jaegertros/Ukulele/CONCERT 14 UKULELE PLANS/genone_luthier_supply.com/cdn.shopify.com/s/files/1/0081/4261/8677/files/Inside_Form_Packages_421b7cd7-5853-4665-a564-590fb22dc92a_600x.jpg

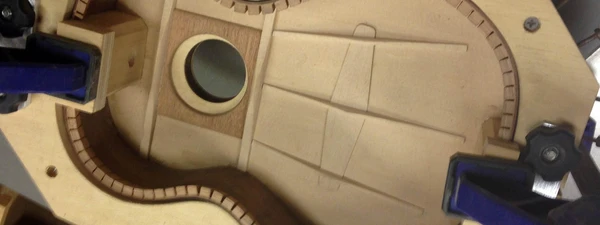
CONCERT 14 UKULELE PLANS/genone_luthier_supply.com/cdn.shopify.com/s/files/1/0081/4261/8677/files/Inside_Form_Packages_421b7cd7-5853-4665-a564-590fb22dc92a_600x.jpg
