jaegertros/Ukulele/CONCERT 14 BELL UKULELE PLANS/genone_luthier_supply.com/cdn.shopify.com/s/files/1/0081/4261/8677/files/IMG_0210_180x180.JPG

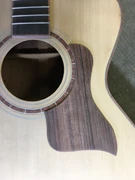
CONCERT 14 BELL UKULELE PLANS/genone_luthier_supply.com/cdn.shopify.com/s/files/1/0081/4261/8677/files/IMG_0210_180x180.JPG
