jaegertros/Ukulele/cad_drawing-b.png

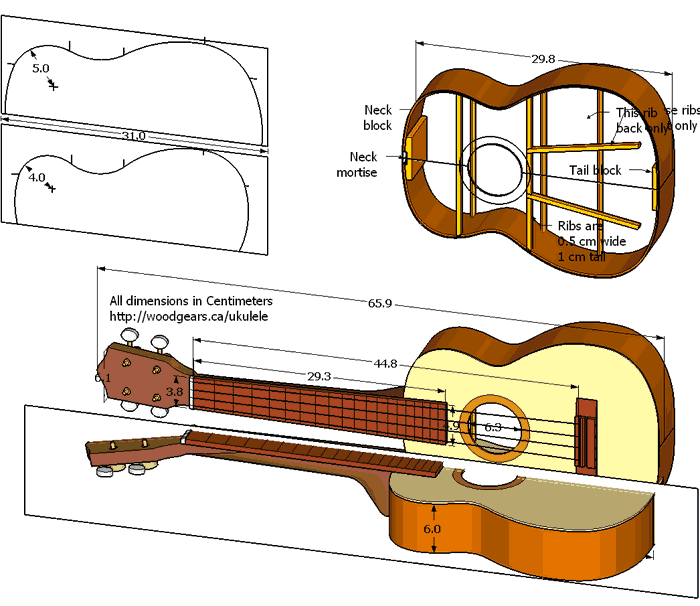
cad_drawing-b.png
