jaegertros/Ukulele/CONCERT 12 UKULELE PLANS/genone_luthier_supply.com/cdn.shopify.com/s/files/1/0081/4261/8677/files/ukulele_600x.jpg

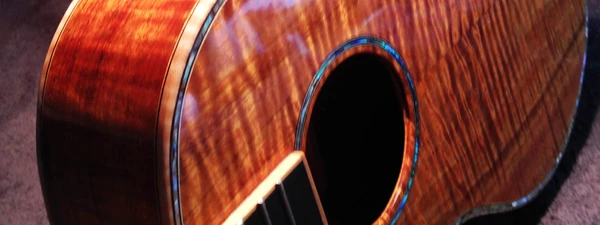
CONCERT 12 UKULELE PLANS/genone_luthier_supply.com/cdn.shopify.com/s/files/1/0081/4261/8677/files/ukulele_600x.jpg
