jaegertros/Ukulele/CONCERT 12 UKULELE PLANS/genone_luthier_supply.com/cdn.shopify.com/s/files/1/0081/4261/8677/products/01_uke14concertplankasha_300x.png

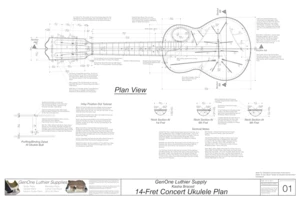
CONCERT 12 UKULELE PLANS/genone_luthier_supply.com/cdn.shopify.com/s/files/1/0081/4261/8677/products/01_uke14concertplankasha_300x.png
