jaegertros/Ukulele/CONCERT 14 BELL UKULELE PLANS/genone_luthier_supply.com/cdn.shopify.com/s/files/1/0081/4261/8677/products/04_ukeconcertdread_4_300x.png

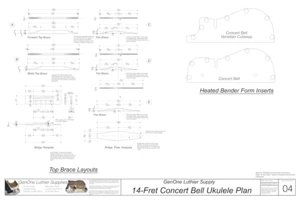
CONCERT 14 BELL UKULELE PLANS/genone_luthier_supply.com/cdn.shopify.com/s/files/1/0081/4261/8677/products/04_ukeconcertdread_4_300x.png
