jaegertros/Ukulele/CONCERT 14 UKULELE PLANS - KASHA BRACED/genone_luthier_supply.com/cdn.shopify.com/s/files/1/0081/4261/8677/products/05_uke14concertplankasha_5_300x.png

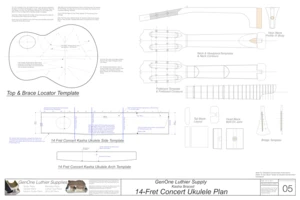
CONCERT 14 UKULELE PLANS - KASHA BRACED/genone_luthier_supply.com/cdn.shopify.com/s/files/1/0081/4261/8677/products/05_uke14concertplankasha_5_300x.png
