jaegertros/Ukulele/CONCERT 14 UKULELE PLANS - KASHA BRACED/genone_luthier_supply.com/cdn.shopify.com/s/files/1/0081/4261/8677/products/06_uke14concertplankashaforms_300x.png

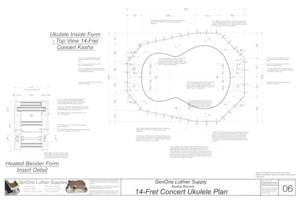
CONCERT 14 UKULELE PLANS - KASHA BRACED/genone_luthier_supply.com/cdn.shopify.com/s/files/1/0081/4261/8677/products/06_uke14concertplankashaforms_300x.png
