jaegertros/Ukulele/CONCERT 14 UKULELE PLANS/02_uke14concertplan_2_300x.jpg

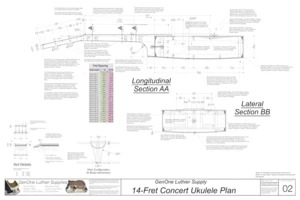
CONCERT 14 UKULELE PLANS/02_uke14concertplan_2_300x.jpg
