jaegertros/Ukulele/CONCERT 14 UKULELE PLANS/genone_luthier_supply.com/cdn.shopify.com/s/files/1/0081/4261/8677/files/CNC_e6f32dc4-443f-4071-a92b-a472cef2e03c_600x.png

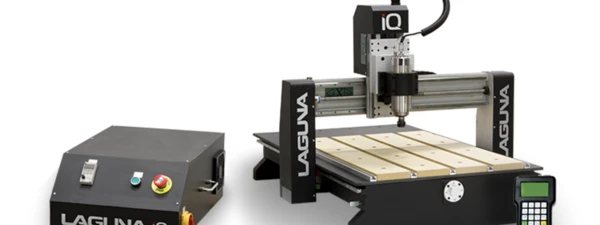
CONCERT 14 UKULELE PLANS/genone_luthier_supply.com/cdn.shopify.com/s/files/1/0081/4261/8677/files/CNC_e6f32dc4-443f-4071-a92b-a472cef2e03c_600x.png
