jaegertros/Ukulele/ukulele_overbend.png

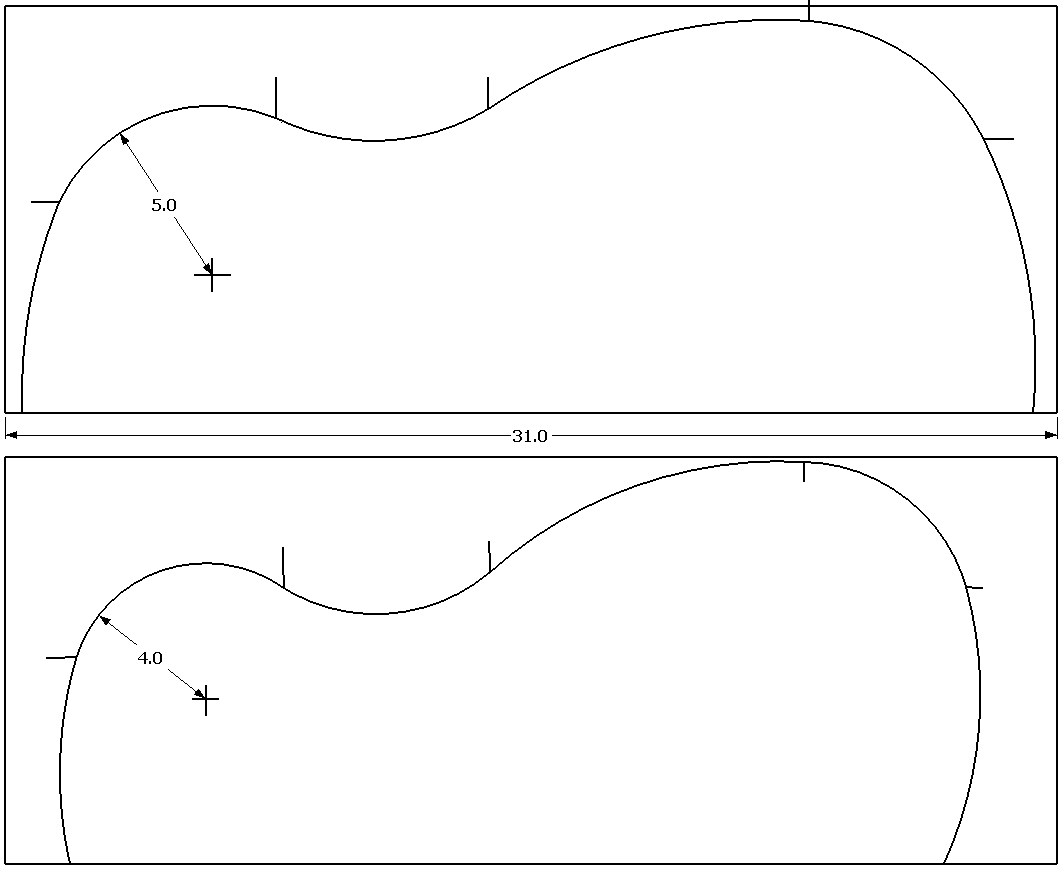
ukulele_overbend.png
