jaegertros/Ukulele/ukulele_profile.png

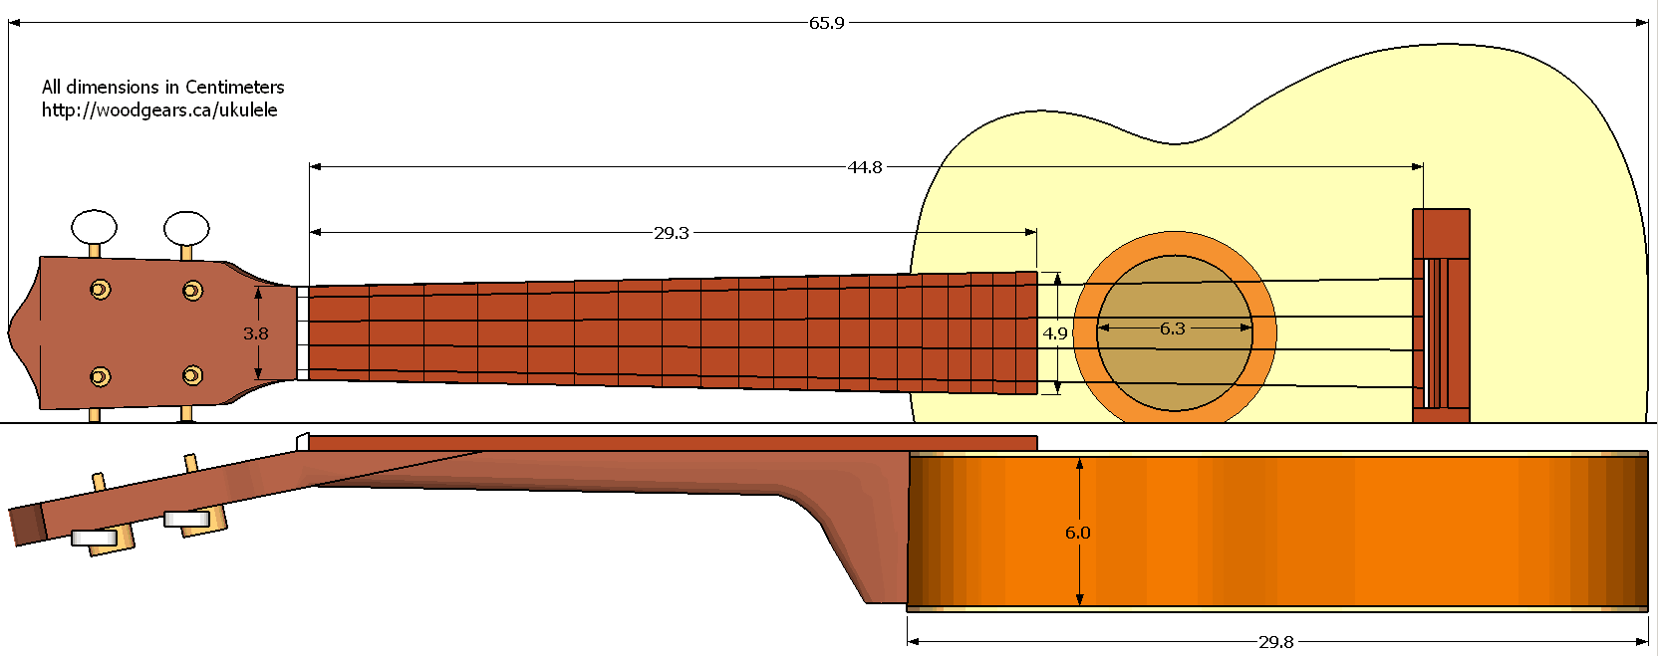
ukulele_profile.png
