jaegertros/Ukulele/ukulele_ribs.png

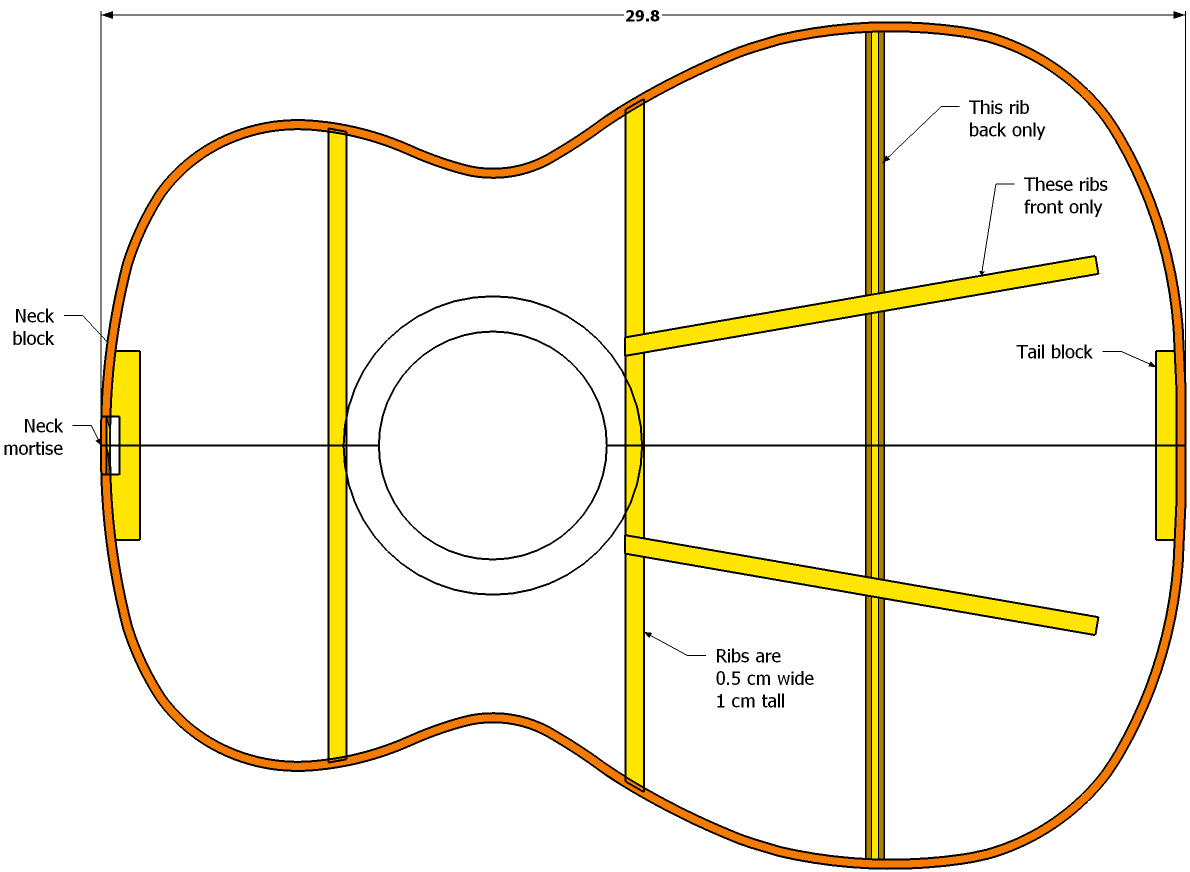
ukulele_ribs.png
