jaegertros/Ukulele/(list of files, cad)

Other CAD files:
ukulele.skp
