jaegertros/Ukulele/woodgears.ca-Making the ukulele fretboard.pdf

## Making the ukulele fretboard

woodgears.ca/ukulele/fretboard.html

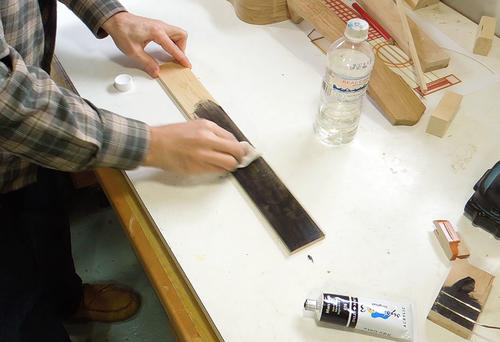
[picture p207: figure]

I used hard maple for the fretboard.

Traditionally, these are made from dark exotic woods, so I figured a dark fretboard would look much better. So I used some black acrylic artist paint to stain the board black.

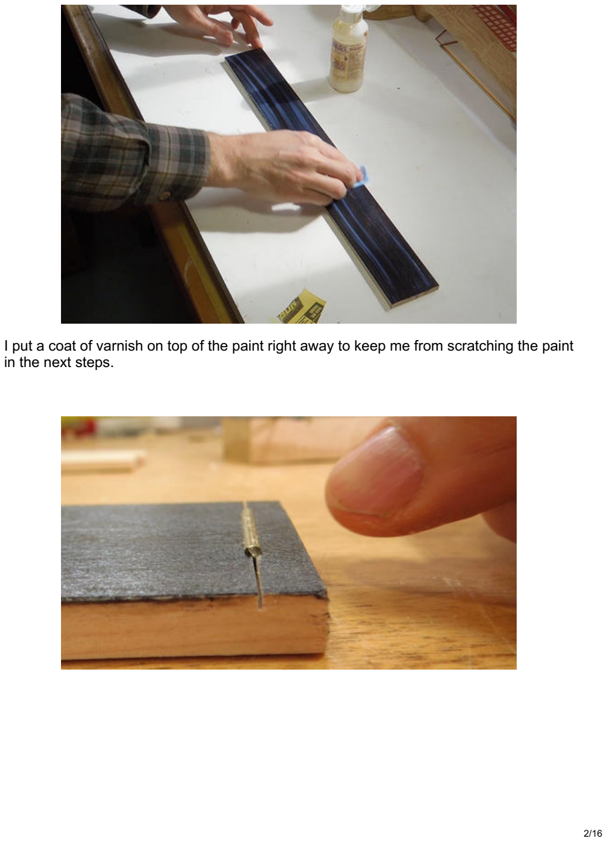
[picture p208: page 2]

I put a coat of varnish on top of the paint right away to keep me from scratching the paint in the next steps.

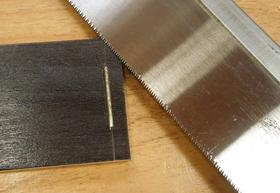
[picture p209: figure]

I tried my Japanese dozuki saw to see if it was suitable for cutting fret slots. I was able to press some scraps of fret into the slot, so I figured the kerf from that saw was wide enough.

### Spacing out the frets

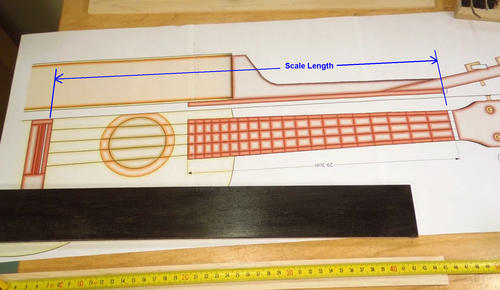
[picture p210: figure]

There are various tools on the web to help you calculate the layout for the frets for guitars or ukuleles. But it's so easy to work these out with a pocket calculator that it's hardly worth the time to learn how to use one of these tools.
I start by determining the "scale length" of my ukulele. The scale length is the length of free string between the bridge and the "nut" at the head of the ukulele.

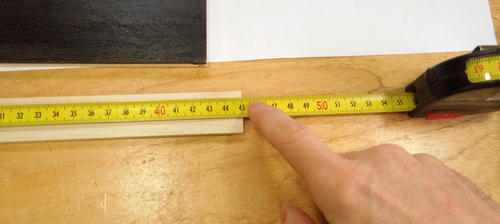
[picture p211: figure]

For my instrument, the scale length came to 45 cm. The math for working out the frets is easy as long as you measure everything from the bridge, not the nut. So I placed my tape measure so that it starts at the bridge position. With my scale length of 45 cm, I put the end of the fretboard (where the "nut" will go) at 45 cm.

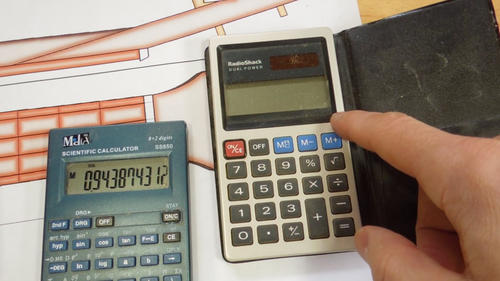
[picture p212: figure]

Starting with the nut, the free string length for each successively higher toned fret is the twelfth root of one half as much. That is, if the nut is at 45 cm, we multiply 45 cm by 0.5 raised to 1/12. So 0.5 raised to one twelfth is 0.94387

I use a calculator with the "constant calculation" feature. Most five function calculators have this feature, but most scientific calculators do not, although this one does. "constant calculation" means that the calculator will repeat the previous operation when
you push "=" again.

So start by multiplying the 0.94387 times itself. Then enter "1" and push "=". If the
display now goes to 0.94387, you are good to go. | 4/16

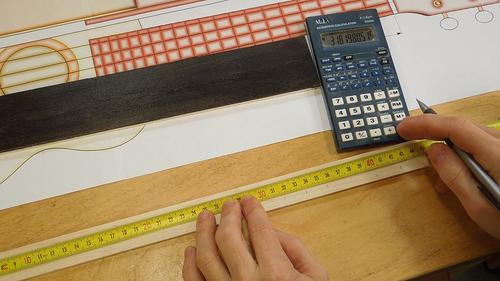
[picture p213: figure]

Now enter the scale length on your calculator and push "=". This should give you the position of the first fret, as measured from the bridge. Mark this position, then push "=" again, and you have the next fret position. Each time you push "=", you get the next fret position.

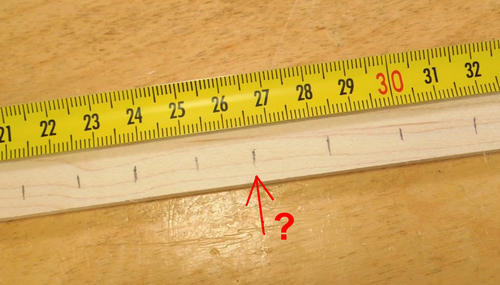
[picture p214: figure]

I marked all the fret positions on a strip of wood. On close inspection, one of the tickmarks looked slightly out of place, so I re-entered the scale length in the calculator and kept pushing "=" again until I got to this position. I had erred by 1.5 mm when I marked this position.

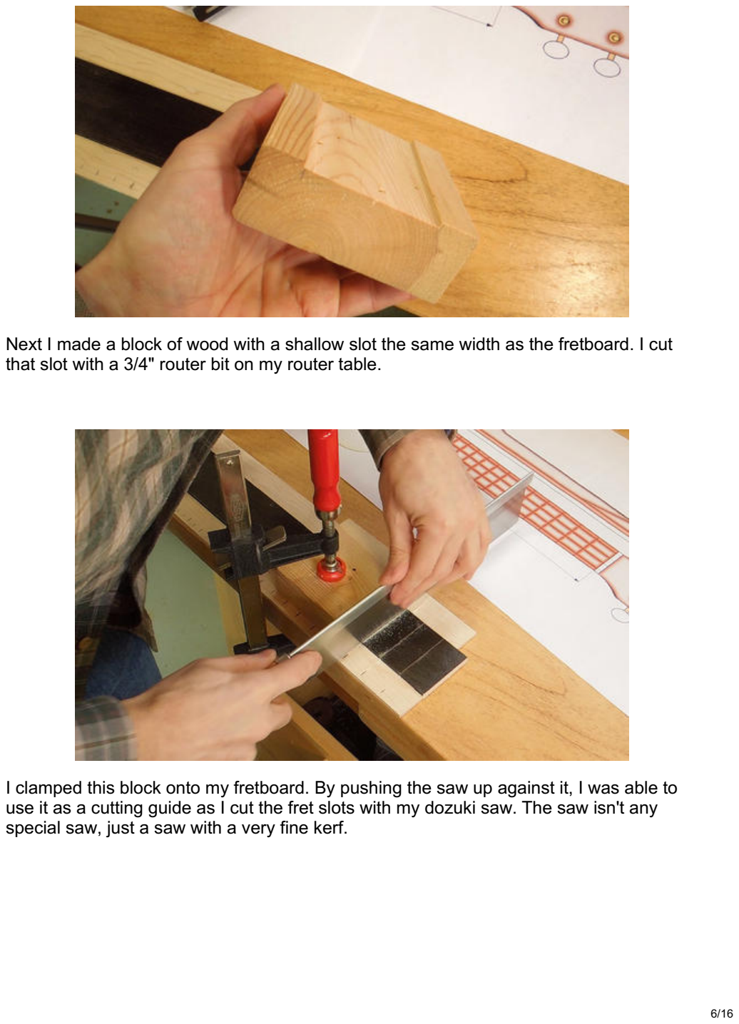
[picture p215: page 6]

Next I made a block of wood with a shallow slot the same width as the fretboard. I cut that slot with a 3/4" router bit on my router table.

I clamped this block onto my fretboard. By pushing the saw up against it, I was able to use it as a cutting guide as I cut the fret slots with my dozuki saw. The saw isn't any special saw, just a saw with a very fine kerf.

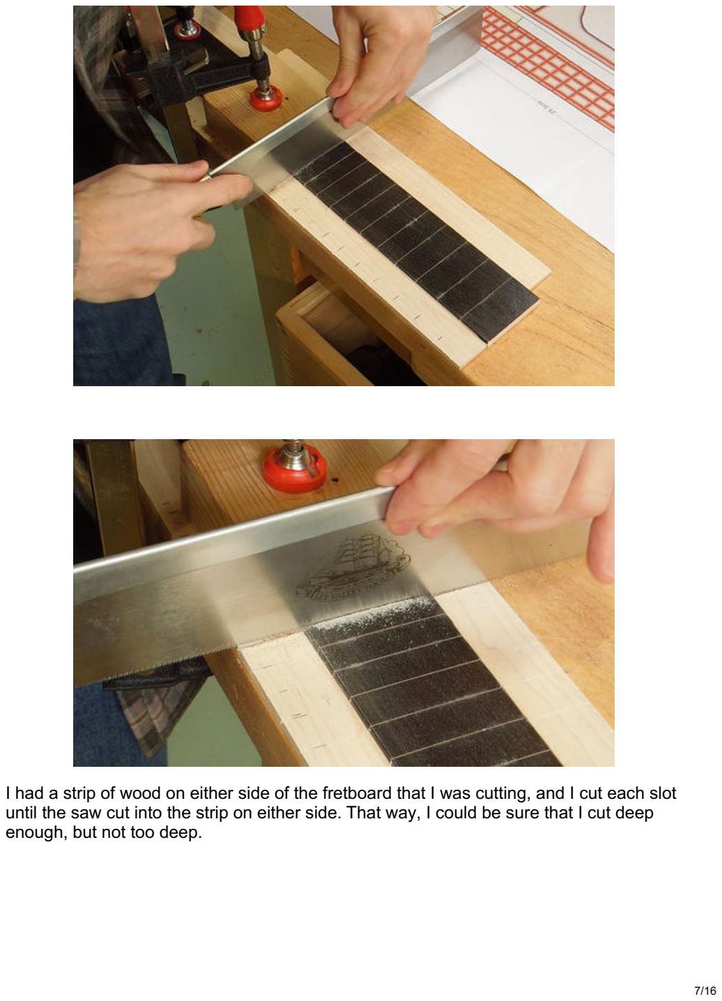
[picture p216: page 7]

I had a strip of wood on either side of the fretboard that I was cutting, and I cut each slot until the saw cut into the strip on either side. That way, I could be sure that I cut deep enough, but not too deep.

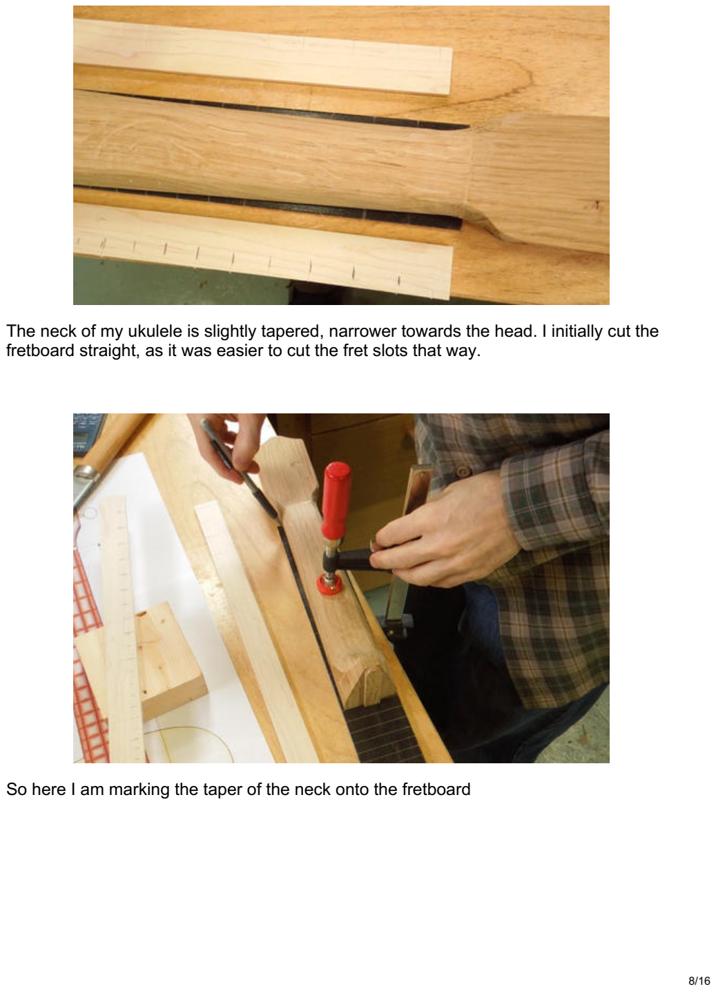
[picture p217: page 8]

The neck of my ukulele is slightly tapered, narrower towards the head. I initially cut the fretboard straight, as it was easier to cut the fret slots that way.

So here I am marking the taper of the neck onto the fretboard

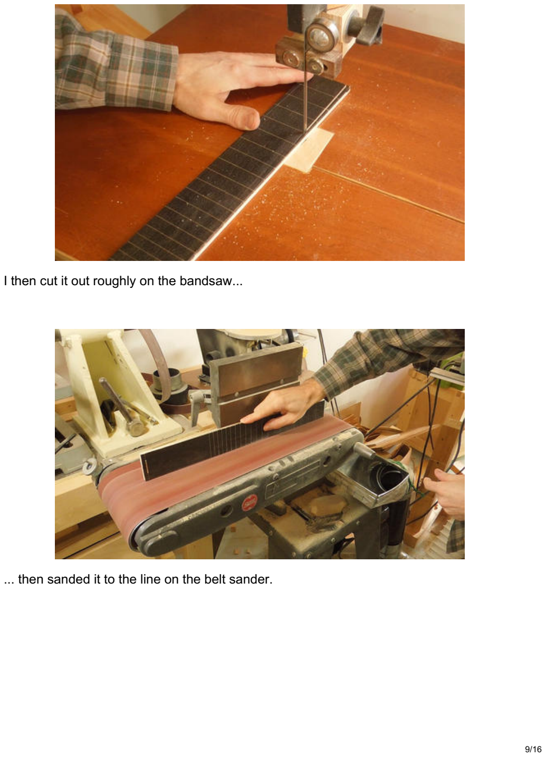
[picture p218: page 9]

I then cut it out roughly on the bandsaw...

... then sanded it to the line on the belt sander.

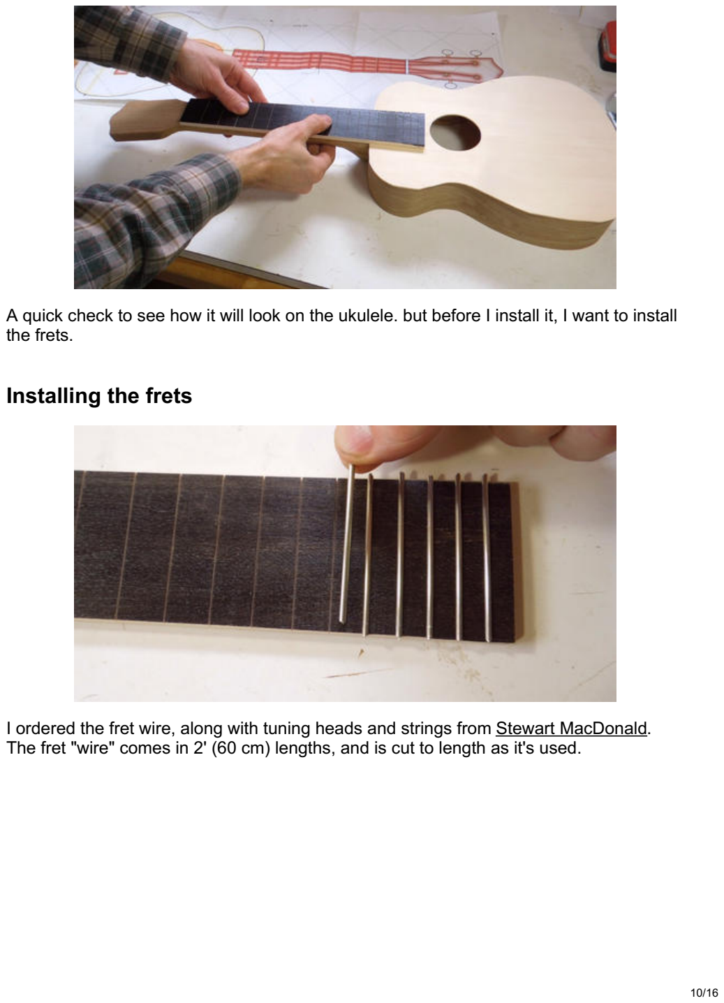
[picture p219: page 10]

A quick check to see how it will look on the ukulele. but before I install it, I want to install the frets.

### Installing the frets

I ordered the fret wire, along with tuning heads and strings from Stewart MacDonald. (http://www.stewmac.com/) The fret "wire" comes in 2' (60 cm) lengths, and is cut to length as it's used.

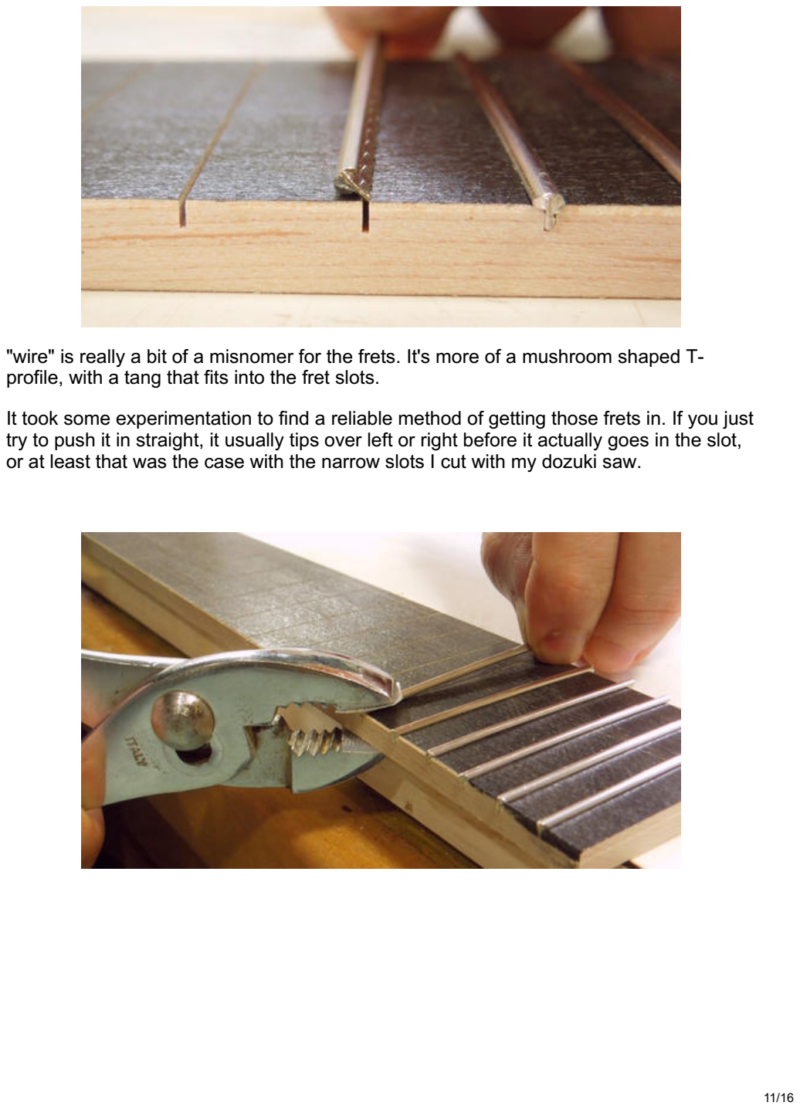
[picture p220: page 11]

"wire" is really a bit of a misnomer for the frets. It's more of a mushroom shaped Tprofile, with a tang that fits into the fret slots.

It took some experimentation to find a reliable method of getting those frets in. If you just try to push it in straight, it usually tips over left or right before it actually goes in the slot, or at least that was the case with the narrow slots I cut with my dozuki saw.

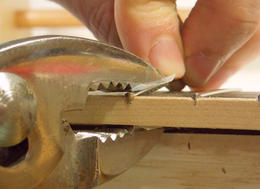
[picture p221: figure]

The method I ended up using was to hold one end of the fret, and squish the other end of it into the slot with pliers. By only squeezing it in at the end, I still had good control of it with my fingers.

I put some pieces of UHMW tape on the jaws of my pliers to keep them from marking up the frets or the wood.

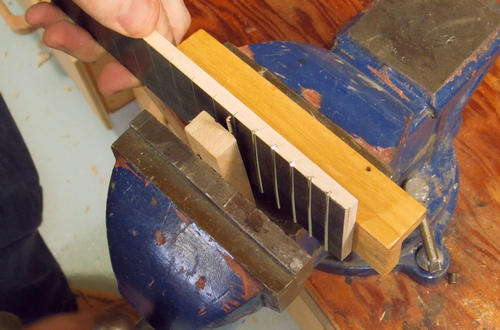
[picture p222: figure]

Once one end of the fret is secure in the slot, it's relatively easy to work across the fretboard to press the rest of it in.

I could have worked it part-way across with the pliers, but that would have caused some sharp bends in the frets. So instead, I used a block of wood in my vise.

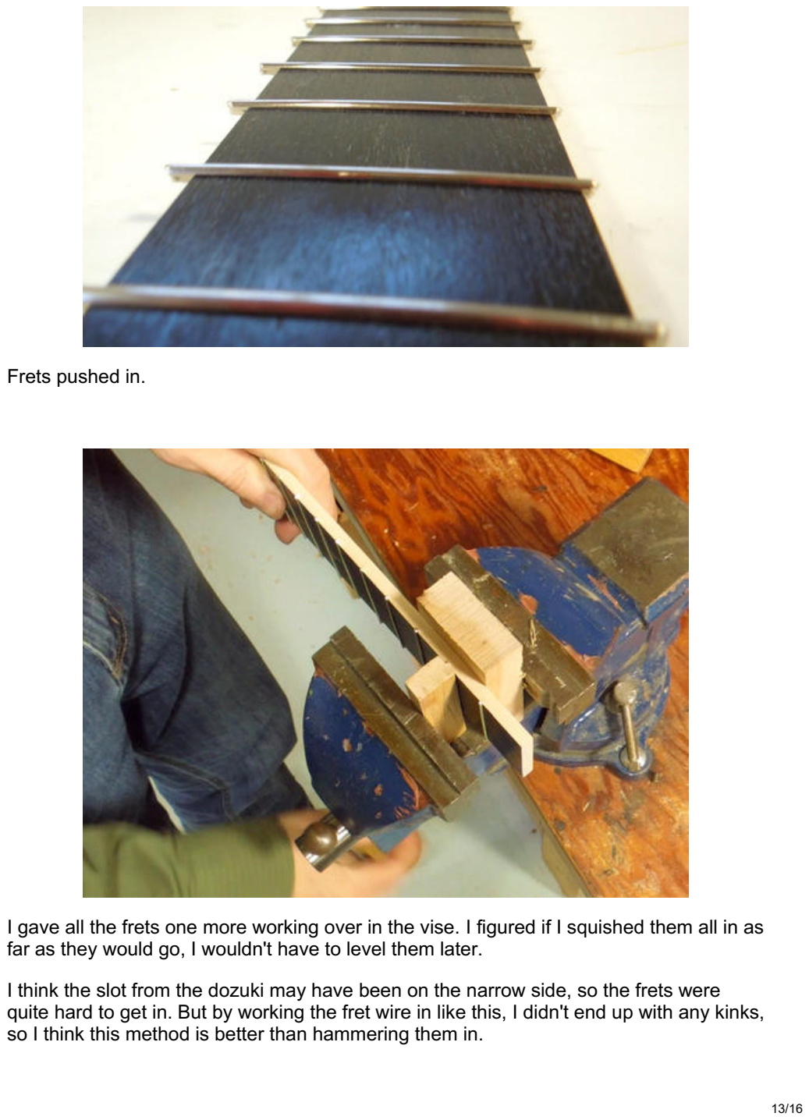
[picture p223: page 13]

Frets pushed in.

I gave all the frets one more working over in the vise. I figured if I squished them all in as far as they would go, I wouldn't have to level them later.

I think the slot from the dozuki may have been on the narrow side, so the frets were
quite hard to get in. But by working the fret wire in like this, I didn't end up with any kinks,
so I think this method is better than hammering them in. | 13/16

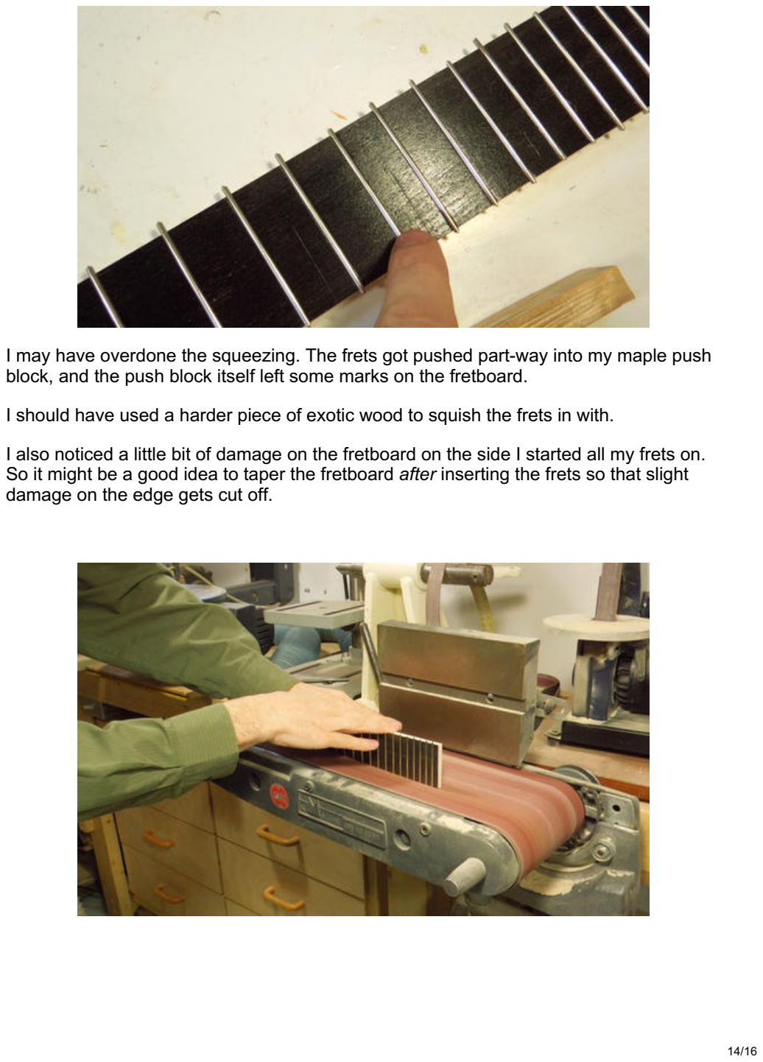
[picture p224: page 14]

I may have overdone the squeezing. The frets got pushed part-way into my maple push block, and the push block itself left some marks on the fretboard.

I should have used a harder piece of exotic wood to squish the frets in with.

I also noticed a little bit of damage on the fretboard on the side I started all my frets on. So it might be a good idea to taper the fretboard after inserting the frets so that slight damage on the edge gets cut off.

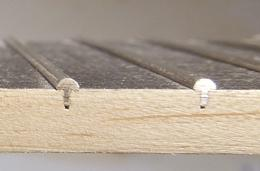
[picture p225: figure]

Next I trimmed the frets flush with the edge on my belt sander. After I got them flush, I tipped the fretboard towards the fret to bevel the ends of the frets in by about 30 degrees.

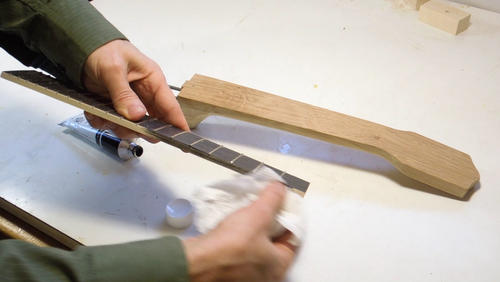
[picture p226: figure]
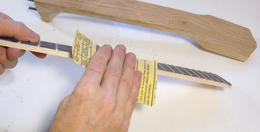
[picture p227: figure]

I also hand-sanded the edges to help round the ends of the frets and the edge of the fretboard between the frets. The edge of the fretboard needs to feel comfortable to reach around.

I then stained the edges of the fretboard to make it look like it was all one black piece of material.

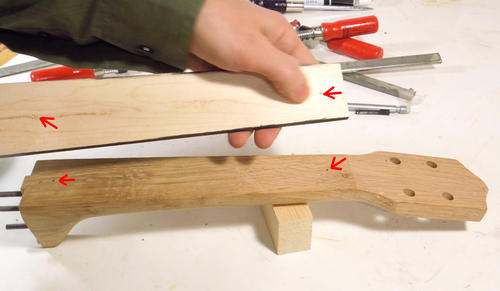
[picture p228: figure]

Glue is a lubricant, and when gluing two flat surfaces together, it often causes the pieces to slide out of alignment. So I drove two finishing nails into the neck and cut them off to stick out about 1.5 mm from the surface.

I then lined up the fretboard and pressed it onto the nails. This resulted in two small divots in the back of the fretboard to keep it aligned during gluing.

See also: Pat making the fretboard (https://woodgears.ca/ukulele/pat_fretboard.html)

Next: Finishing the assembly (https://woodgears.ca/ukulele/finish_up.html)

Drag and Drop

The image will be downloaded

×
