jaegertros/Ukulele/Build a Guitar or Ukulele Body.pdf

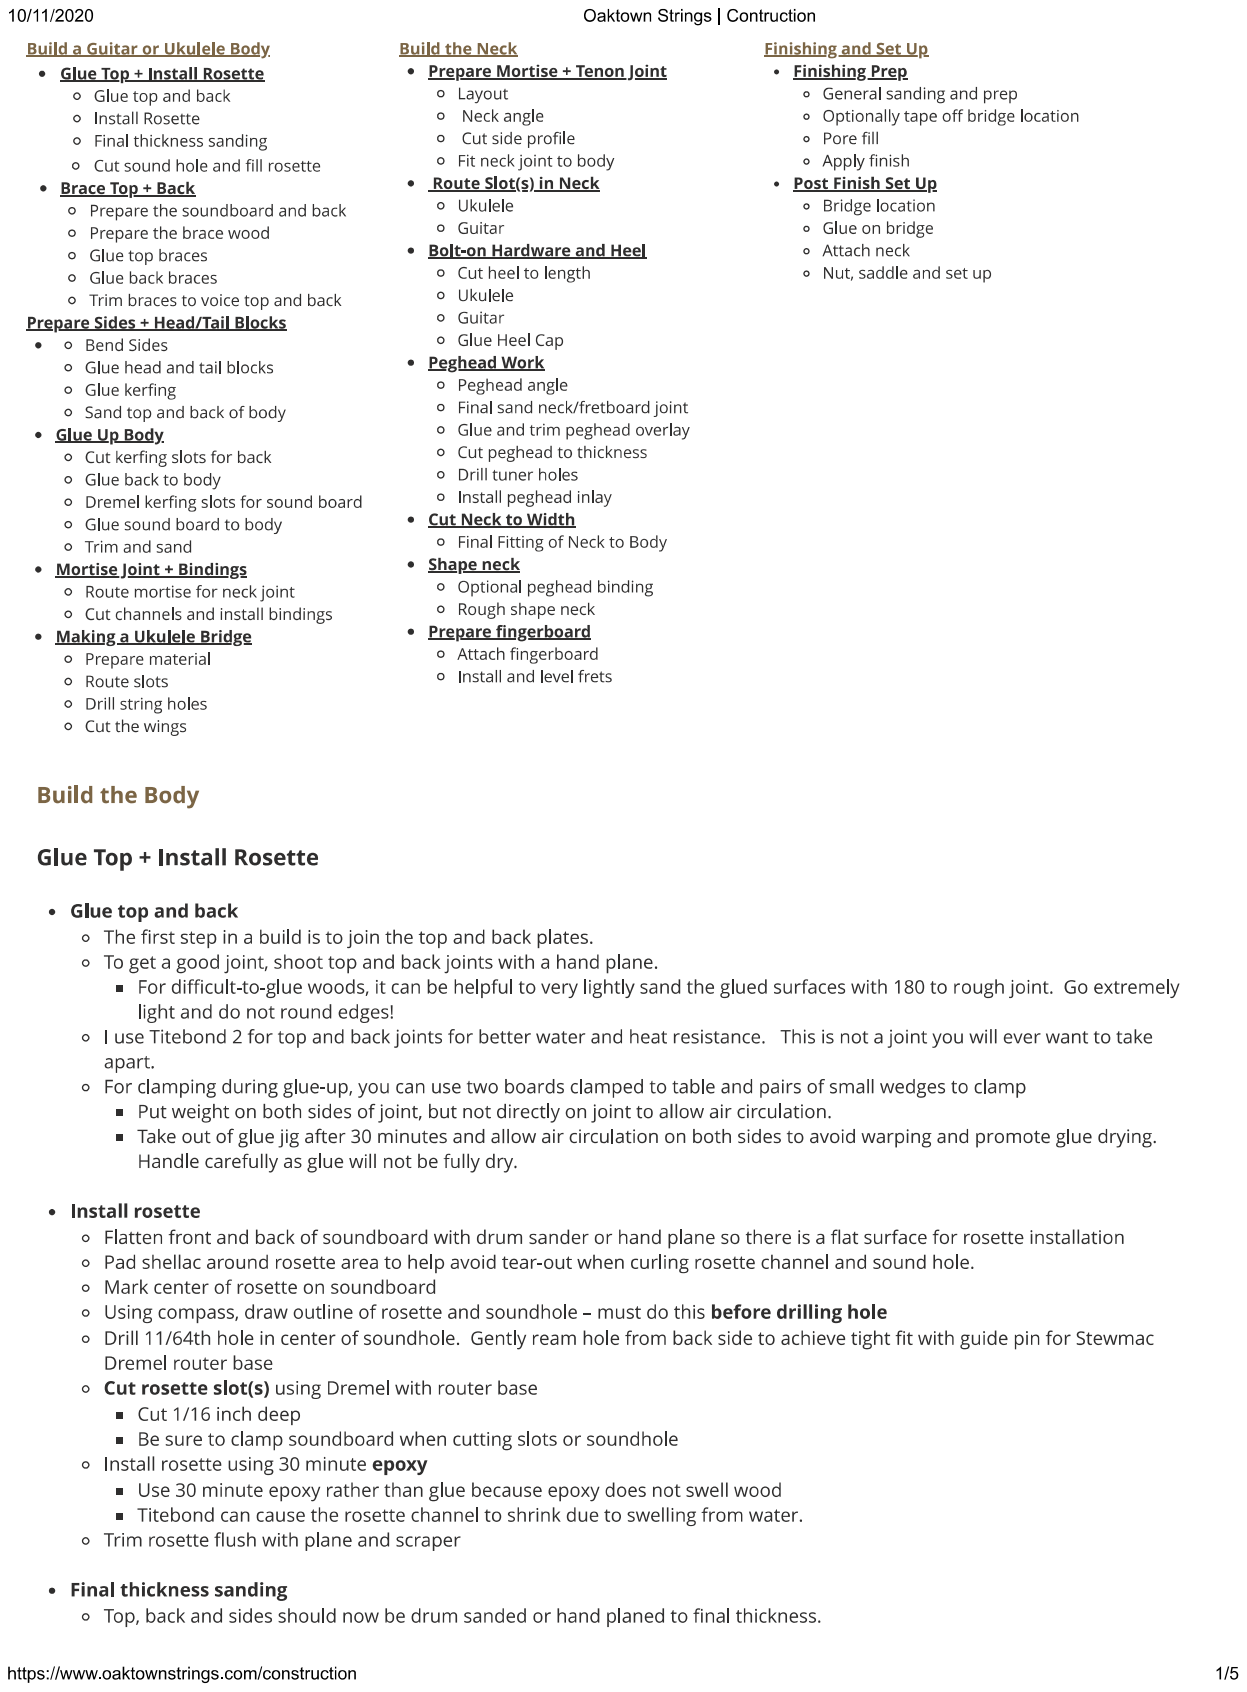
[picture p296: page 1]

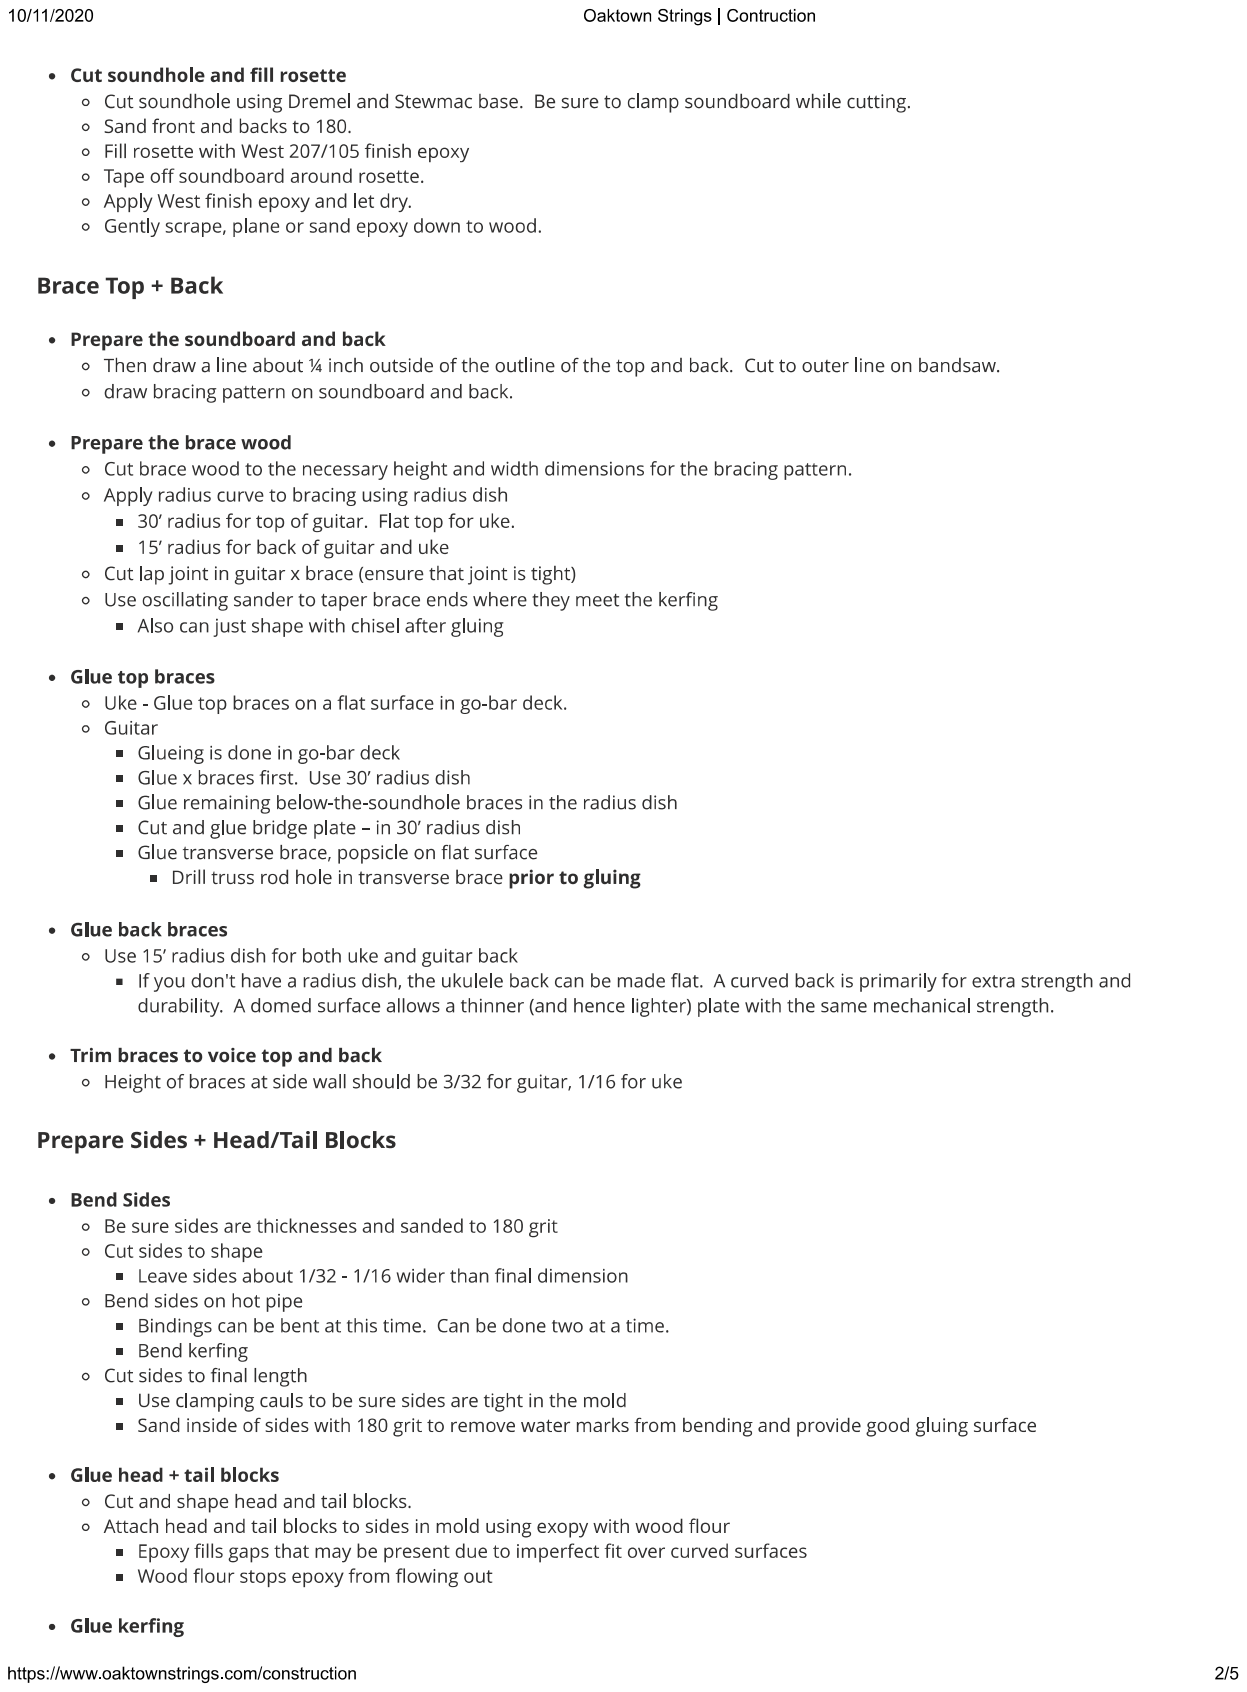
[picture p297: page 2]

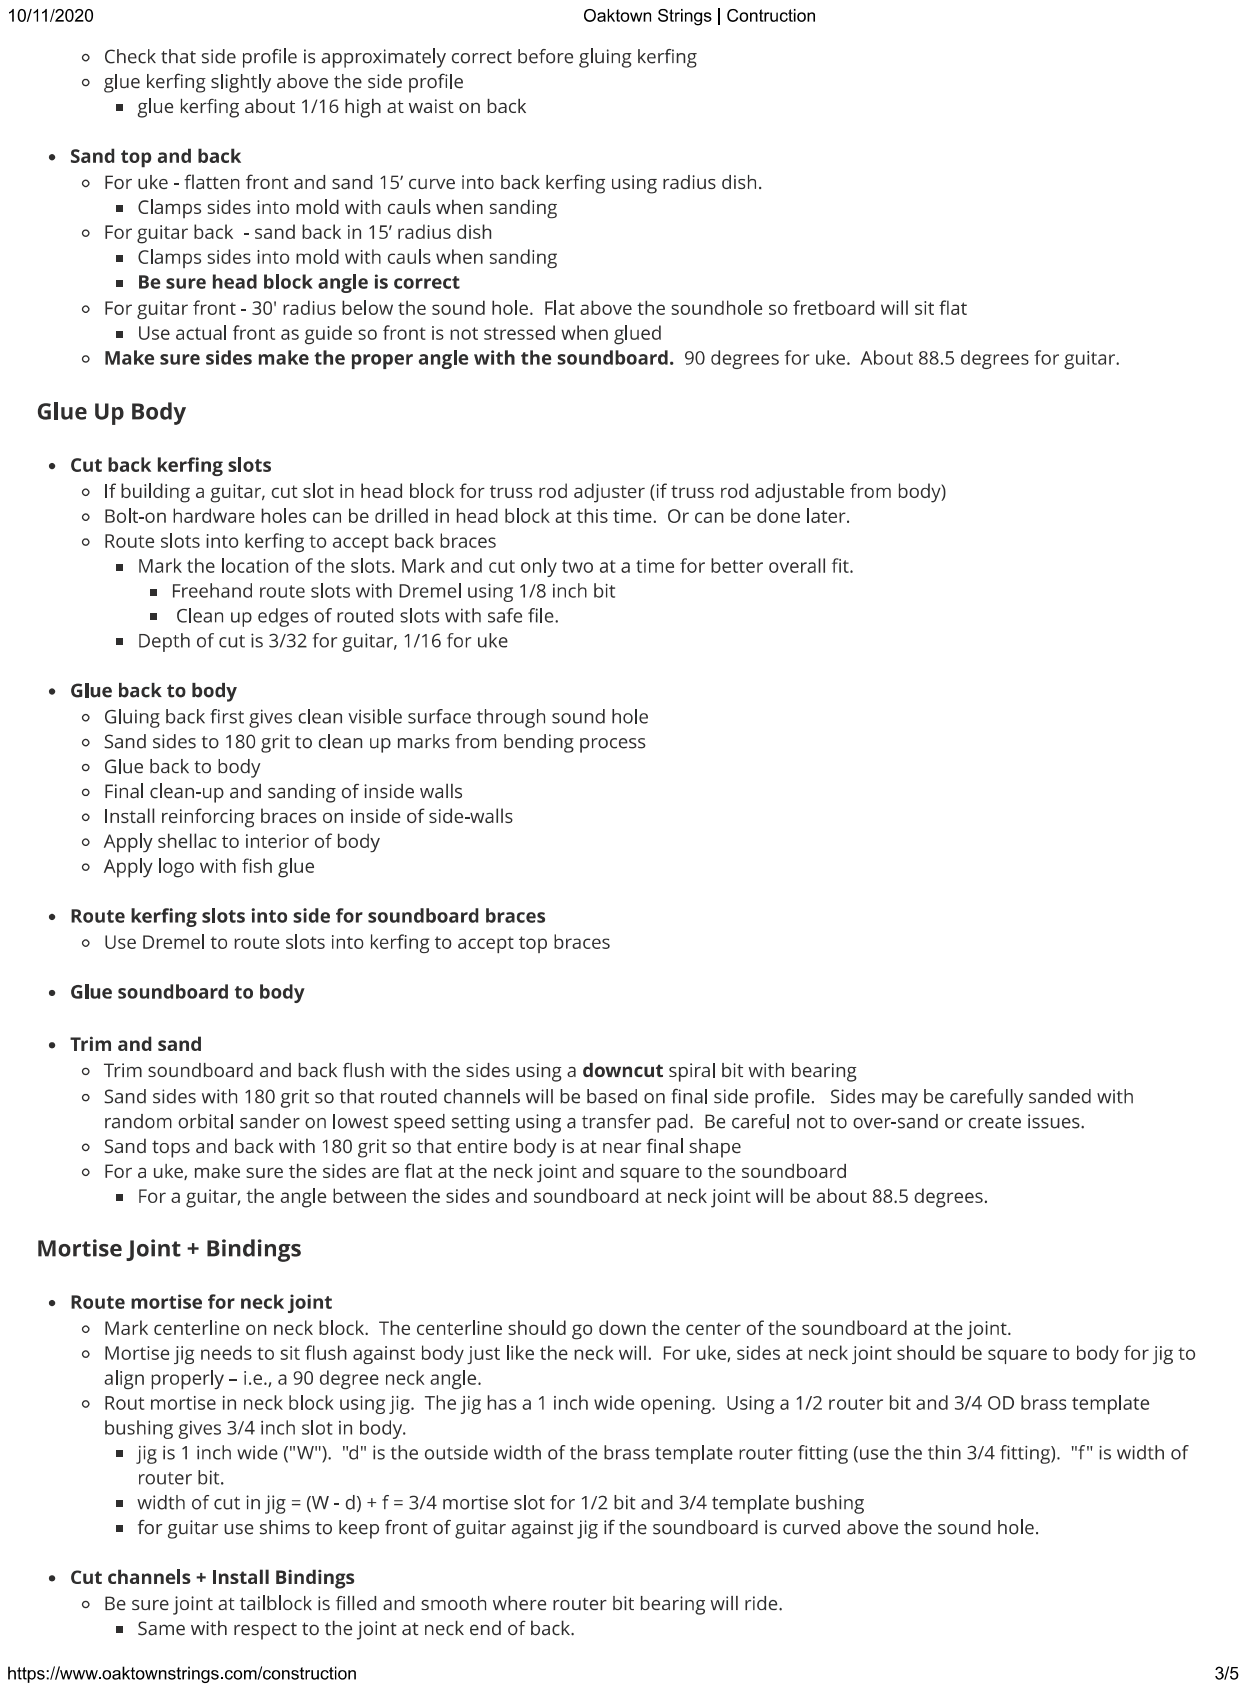
[picture p298: page 3]

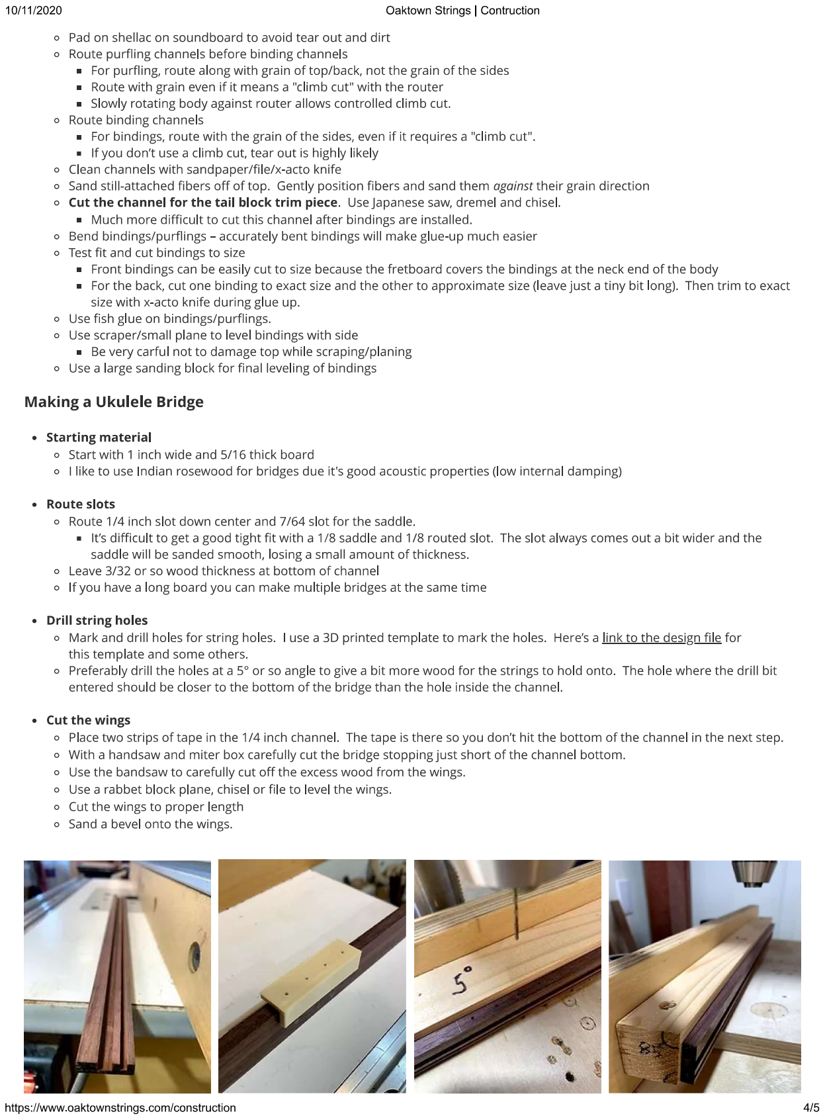
[picture p299: page 4]

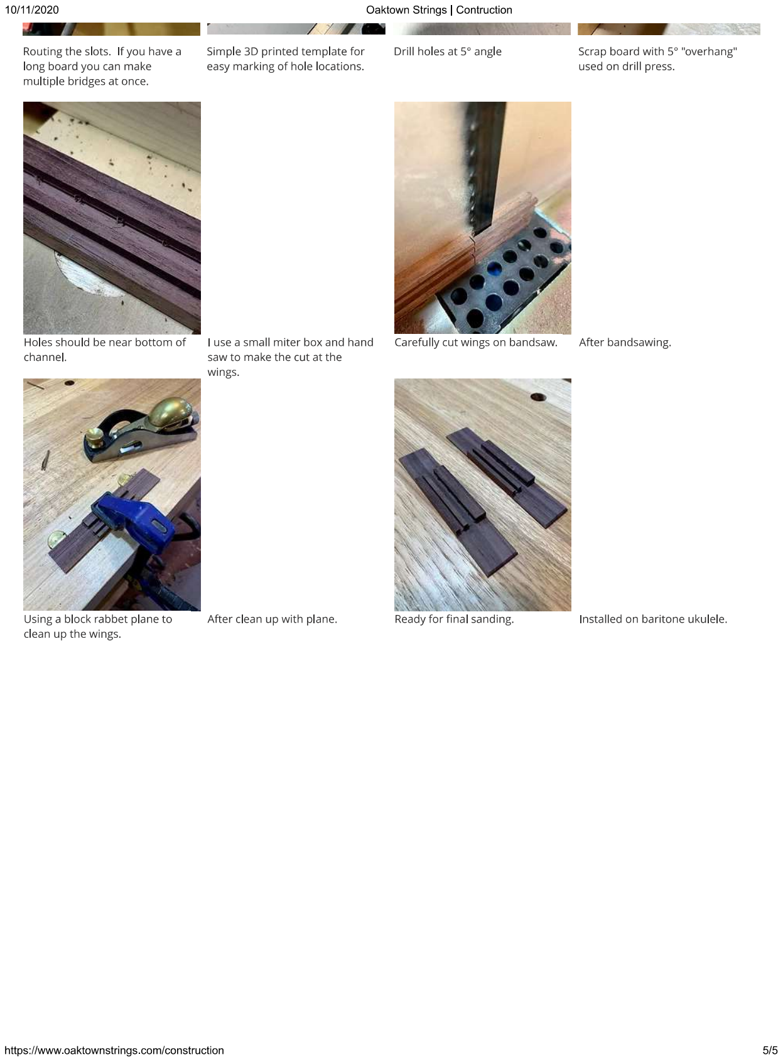
[picture p300: page 5]
