jaegertros/Ukulele/Build finish.pdf

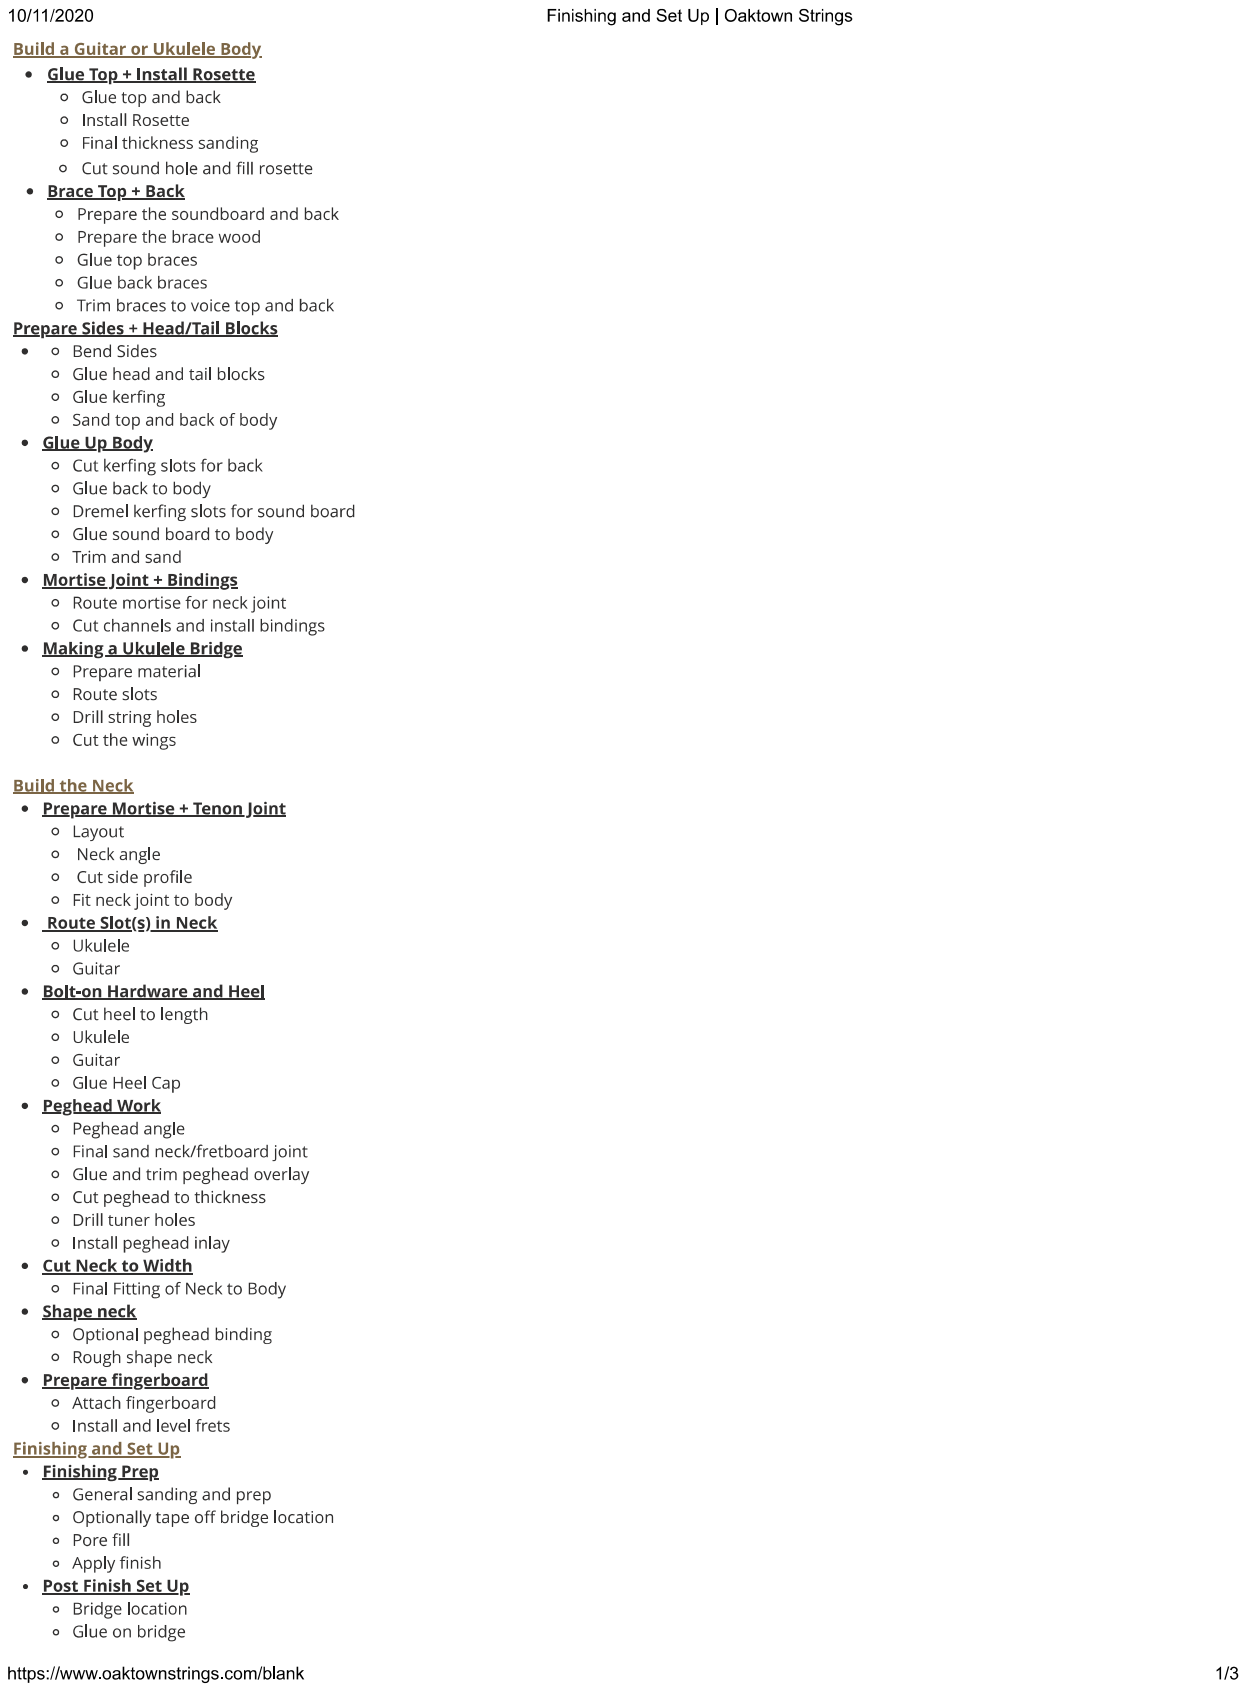
[picture p301: page 1]

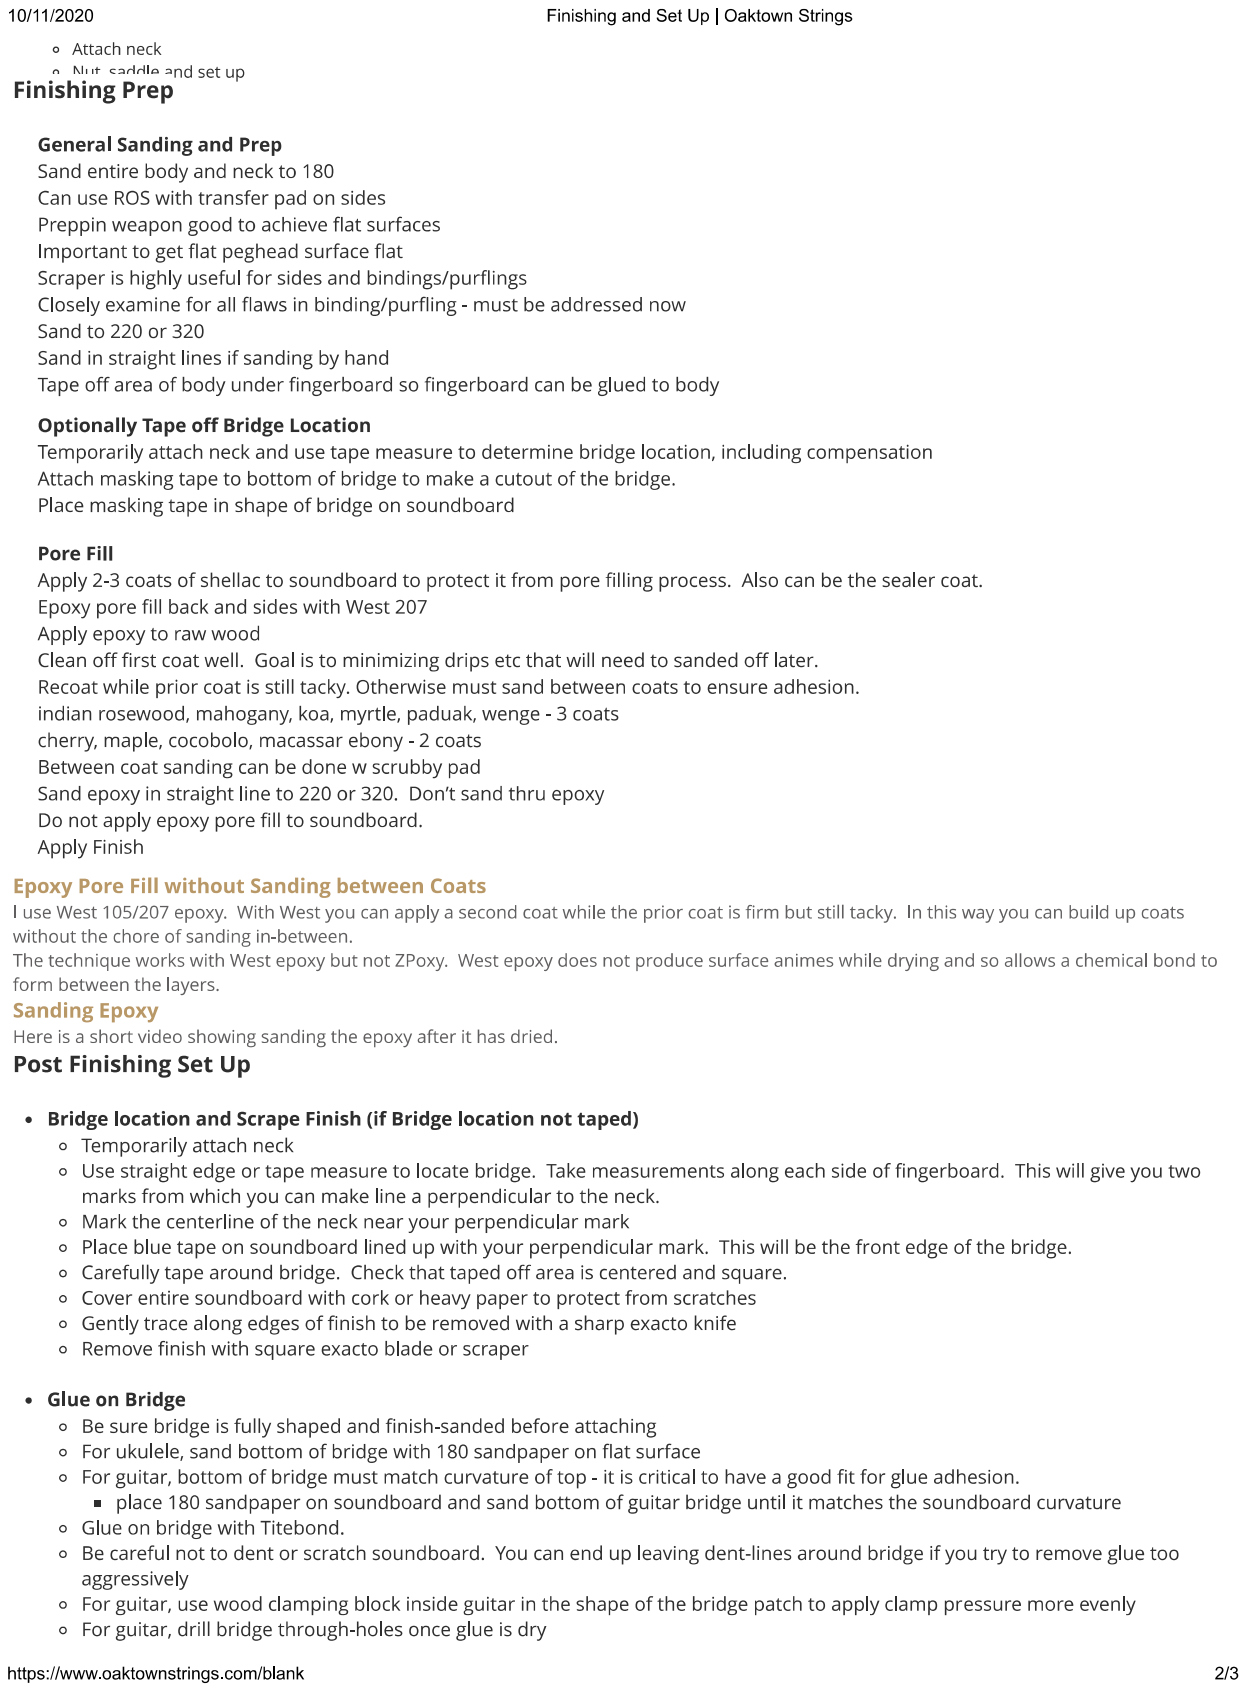
[picture p302: page 2]

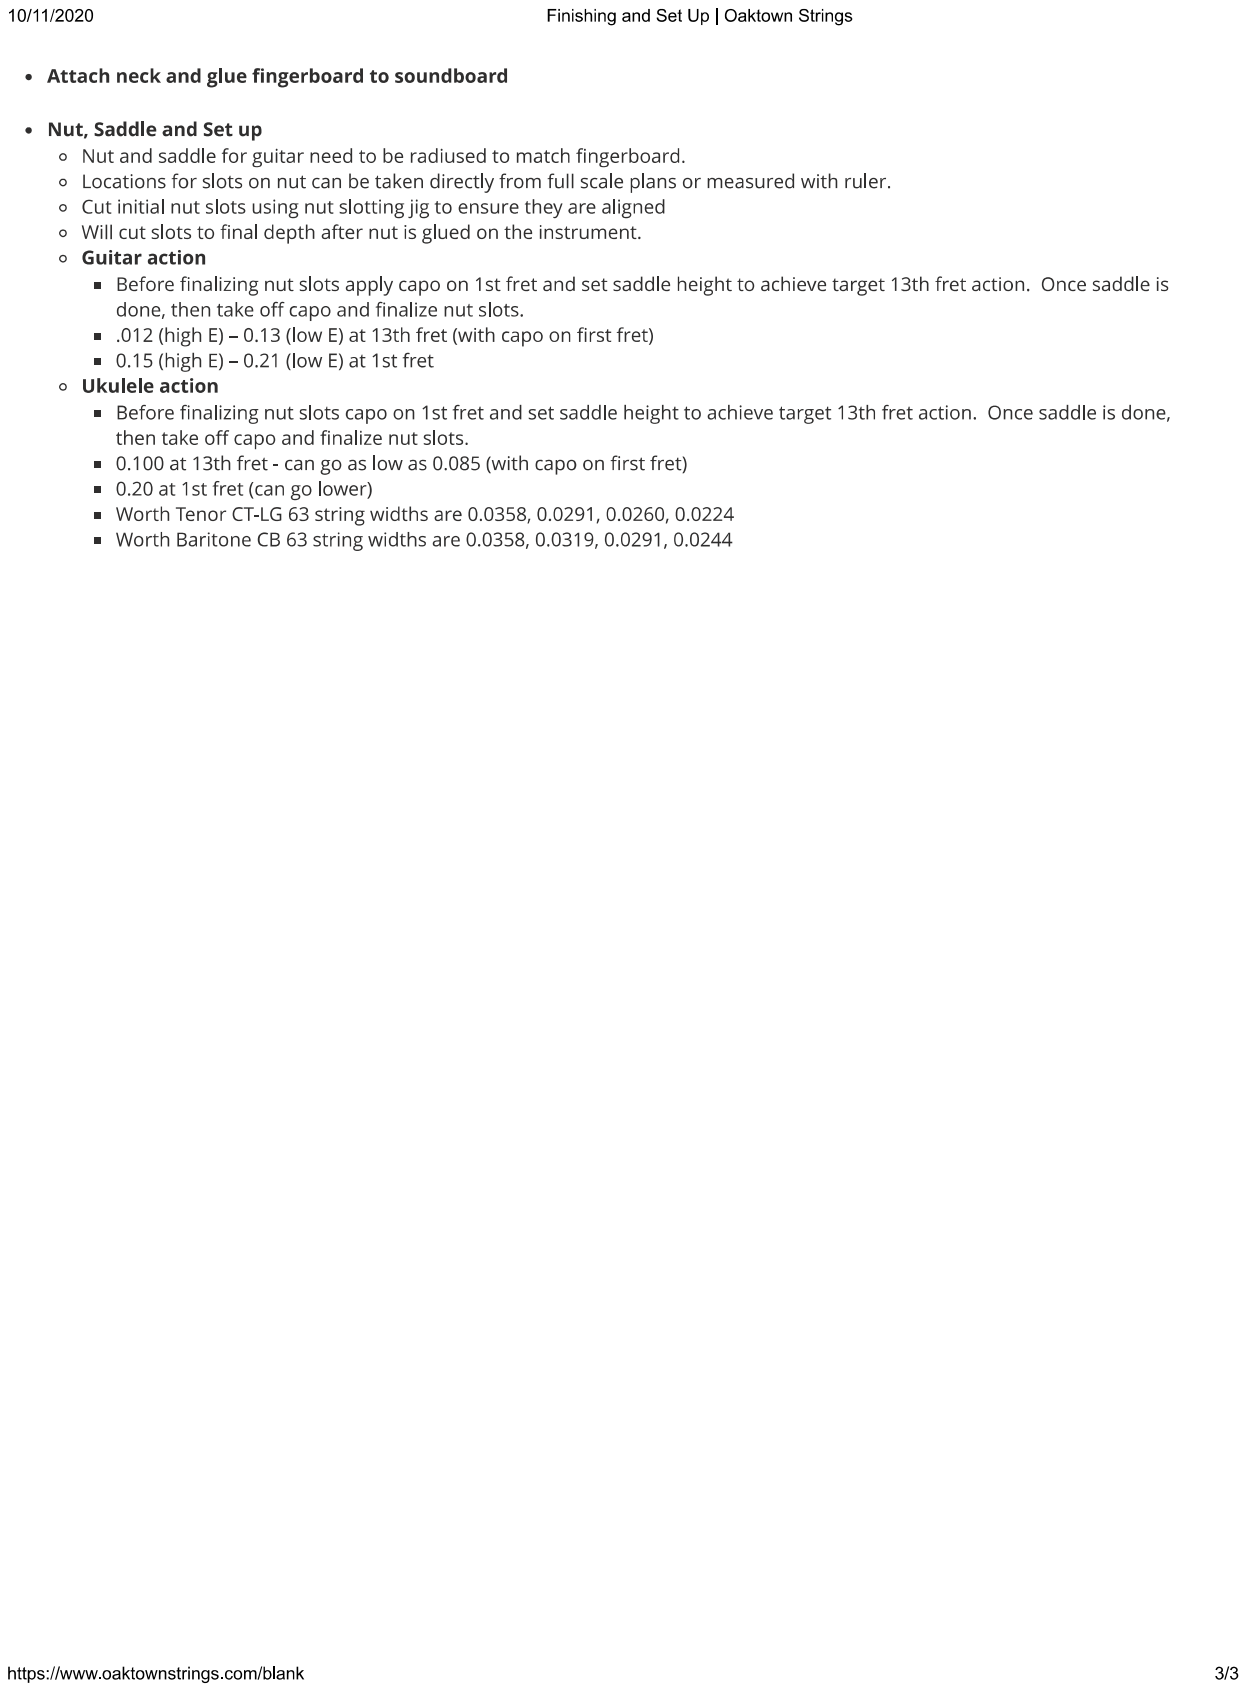
[picture p303: page 3]
