jaegertros/Ukulele/Build the neck.pdf

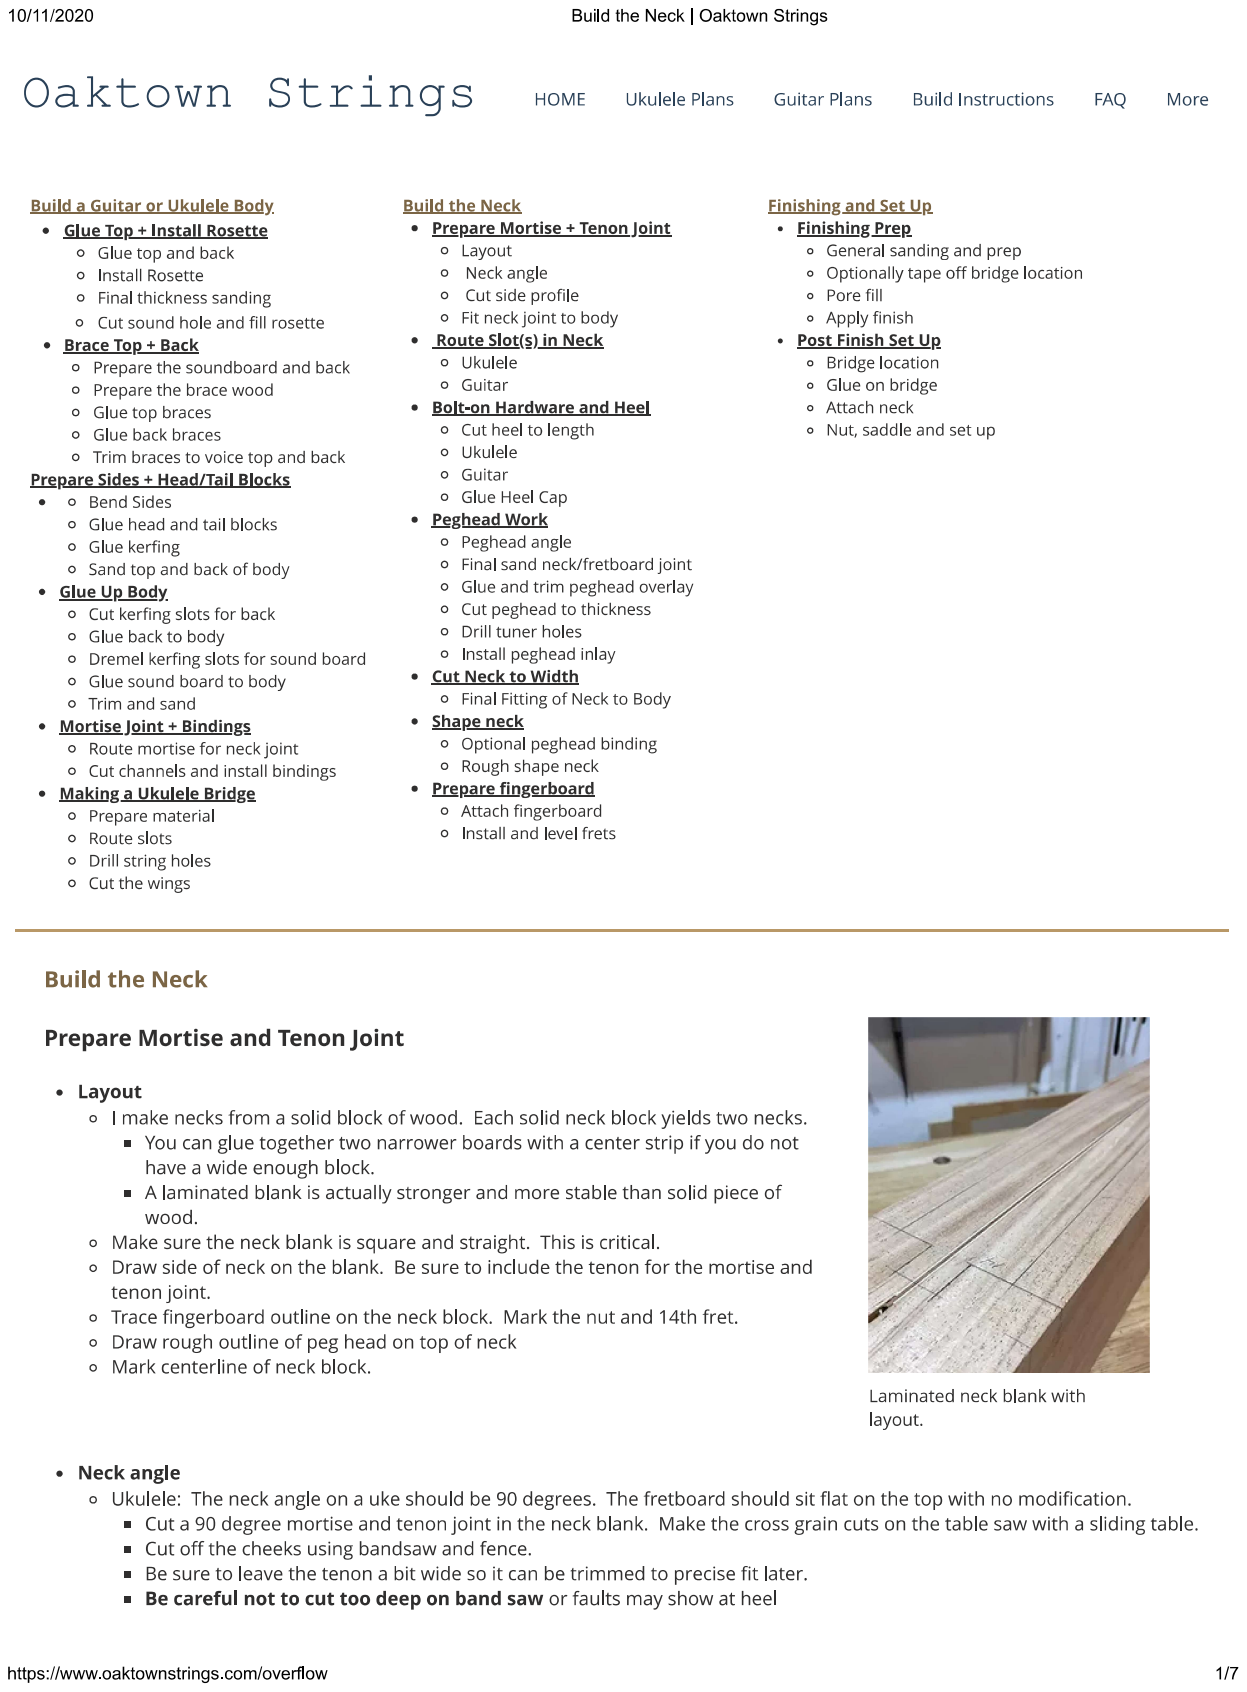
[picture p304: page 1]

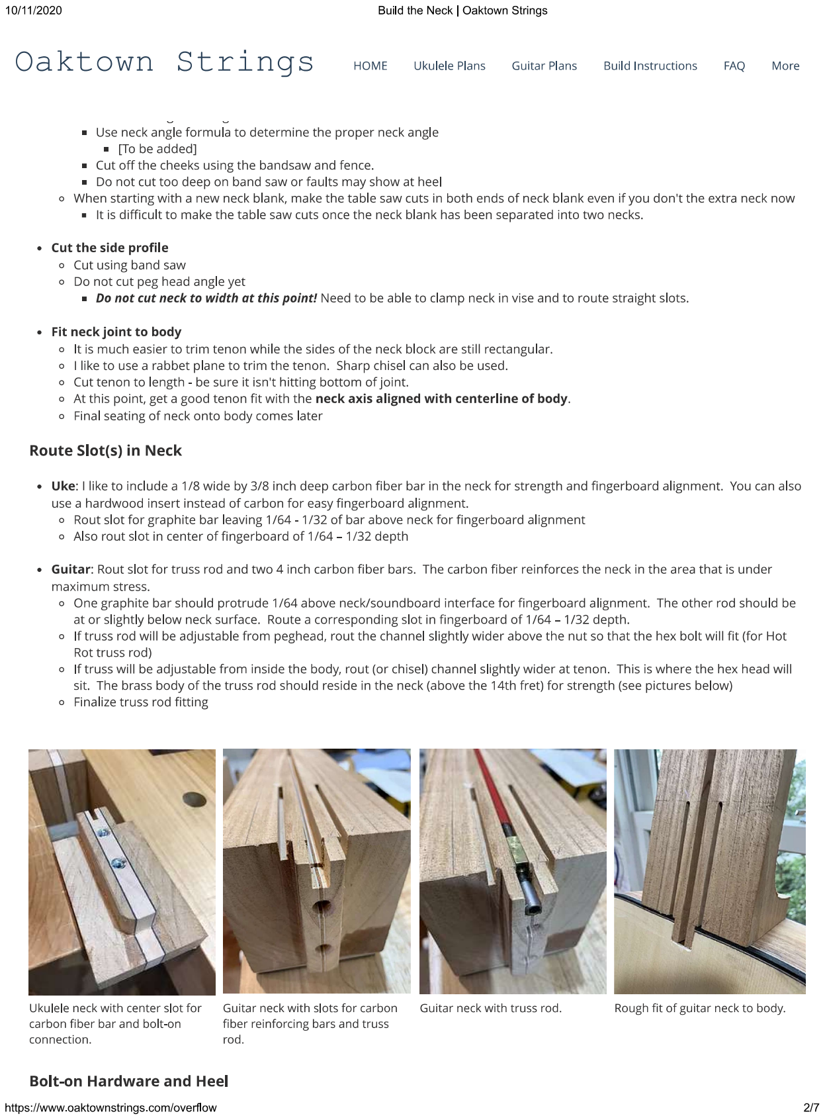
[picture p305: page 2]

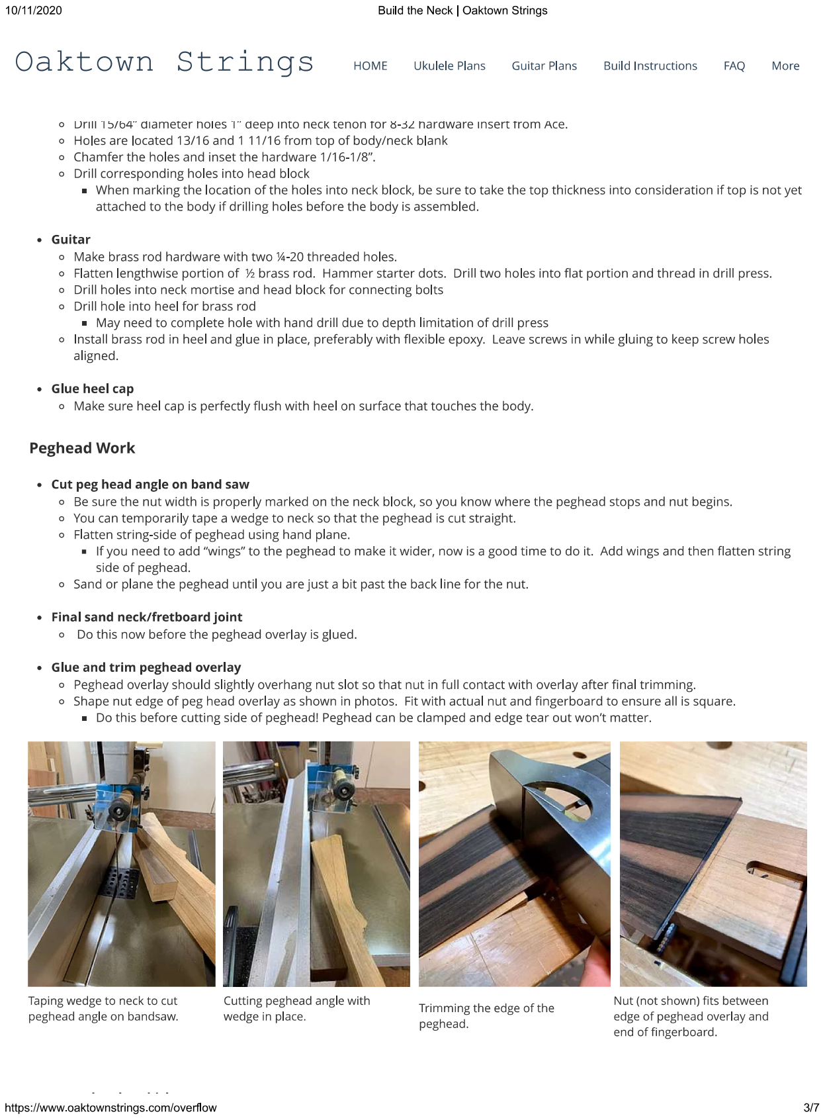
[picture p306: page 3]

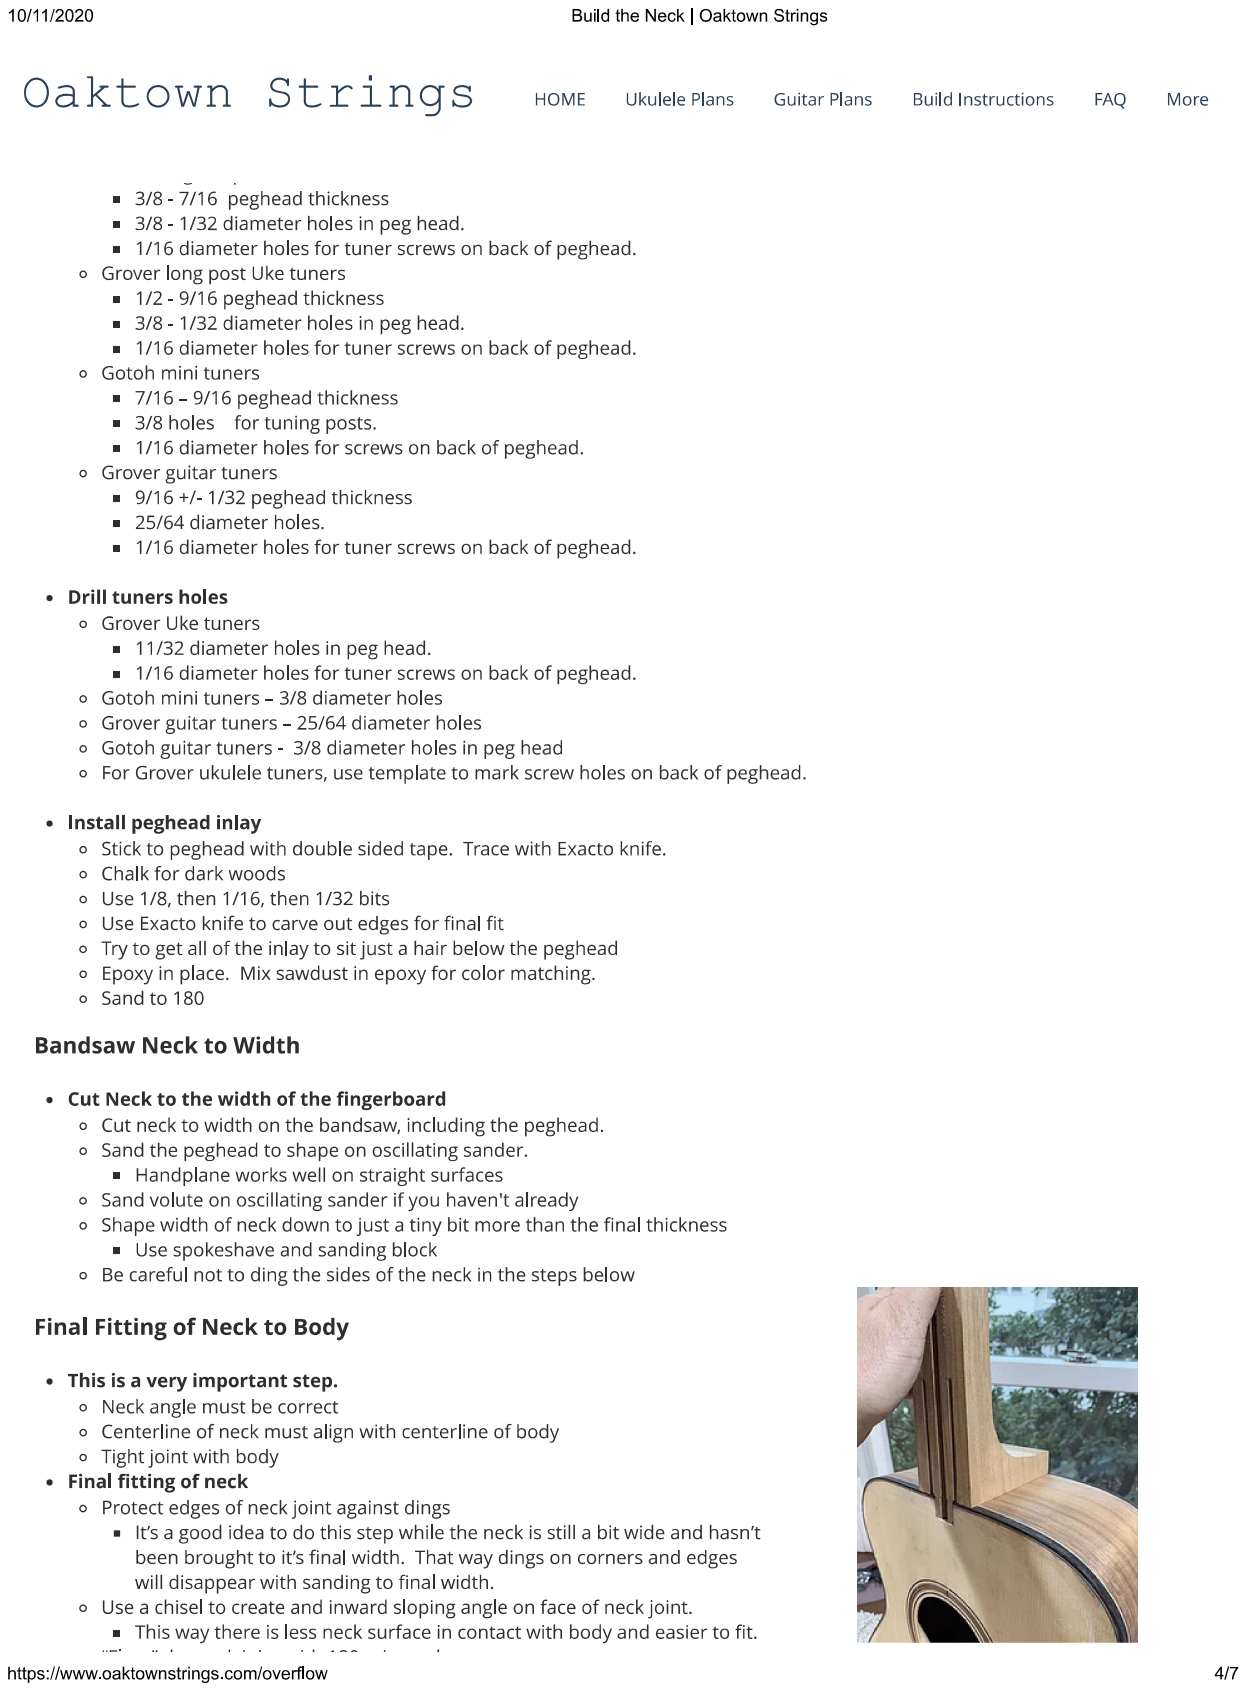
[picture p307: page 4]

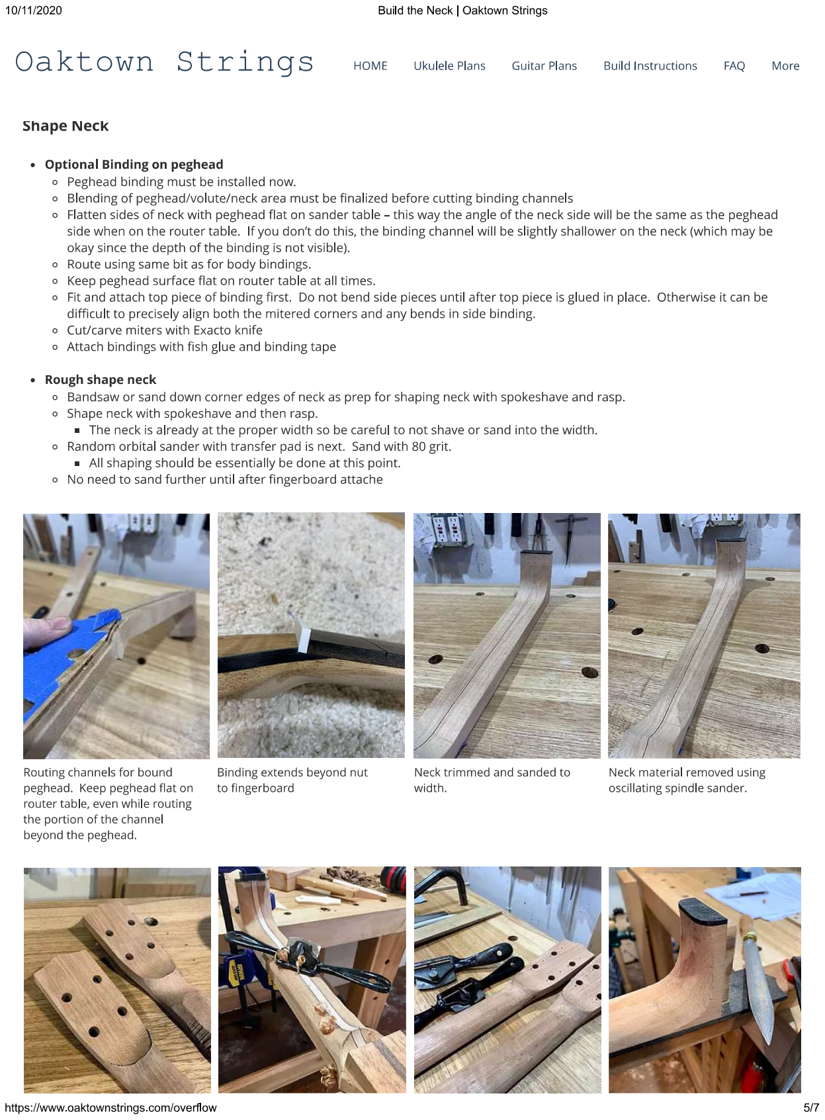
[picture p308: page 5]

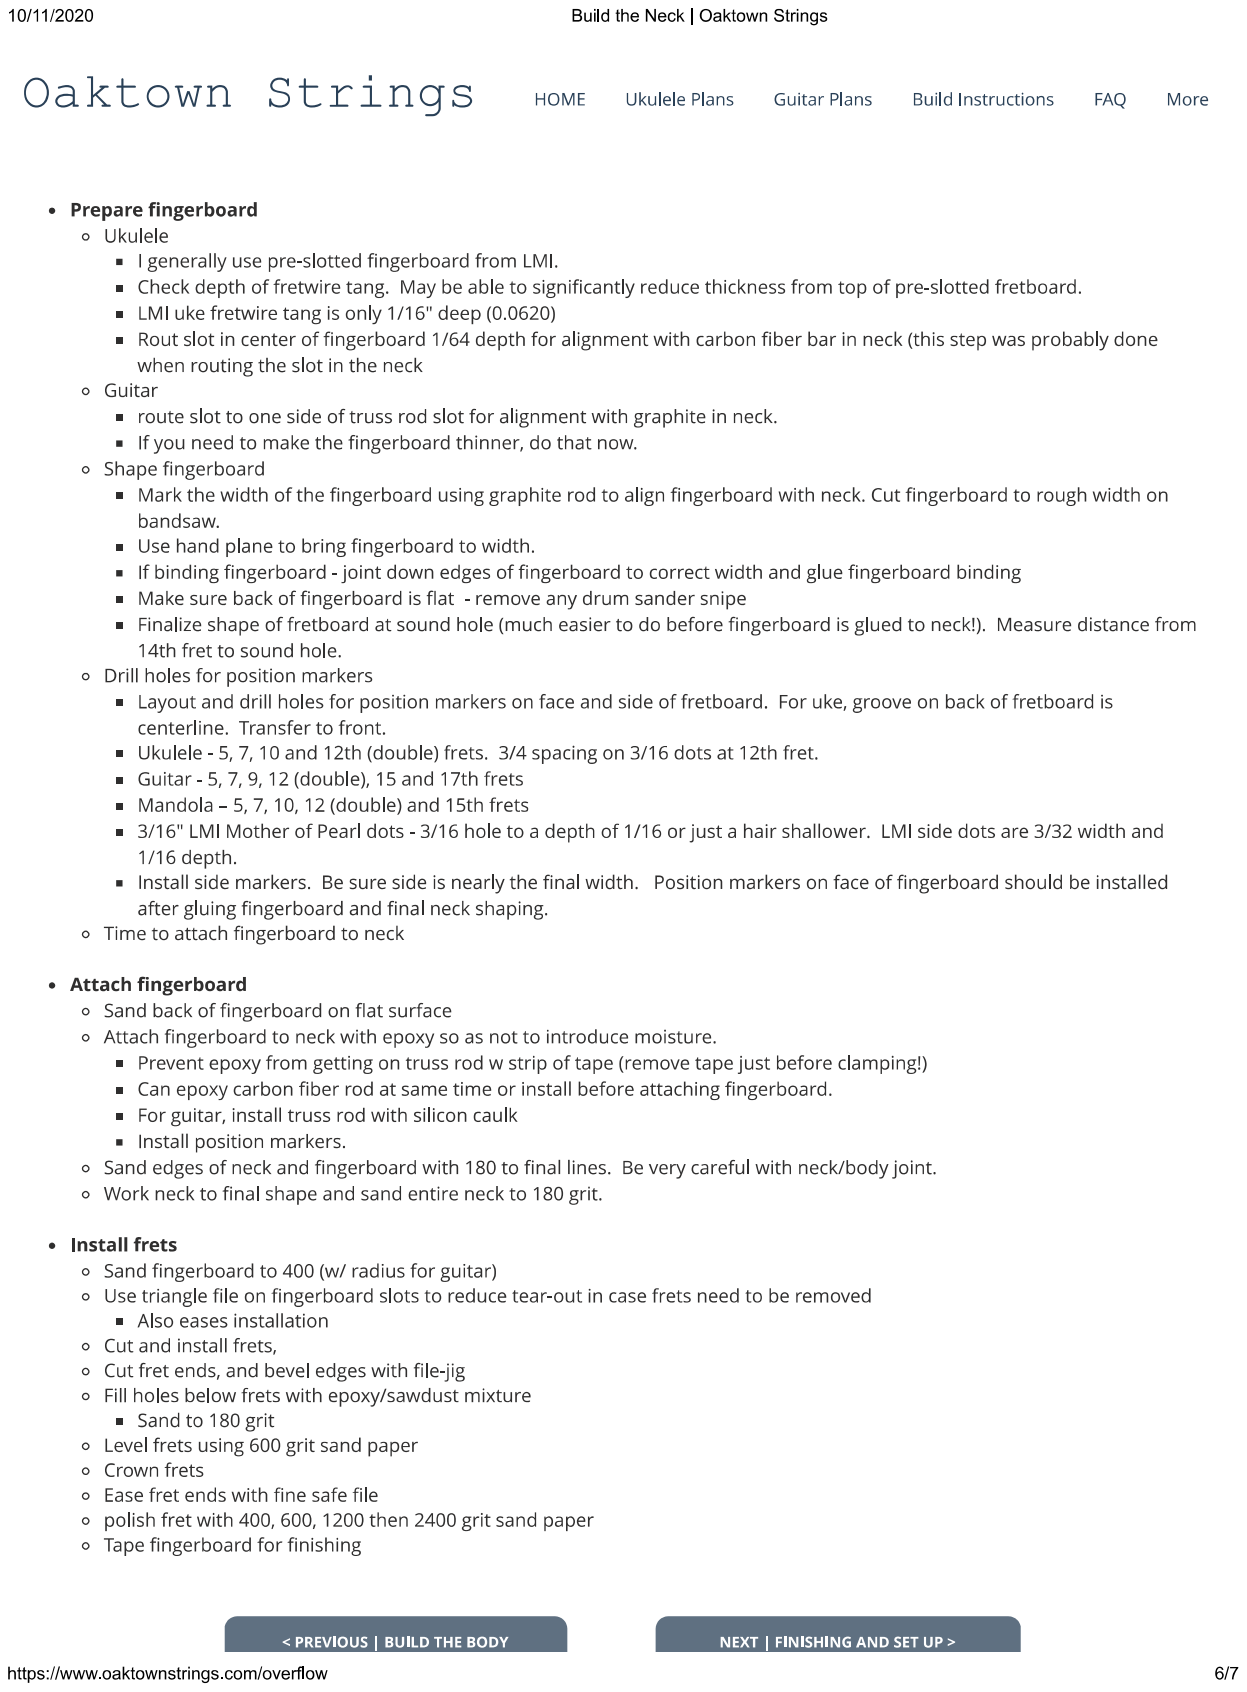
[picture p309: page 6]
