jaegertros/Ukulele/Baritone Ukulele 4 V1.3 - FINAL.pdf

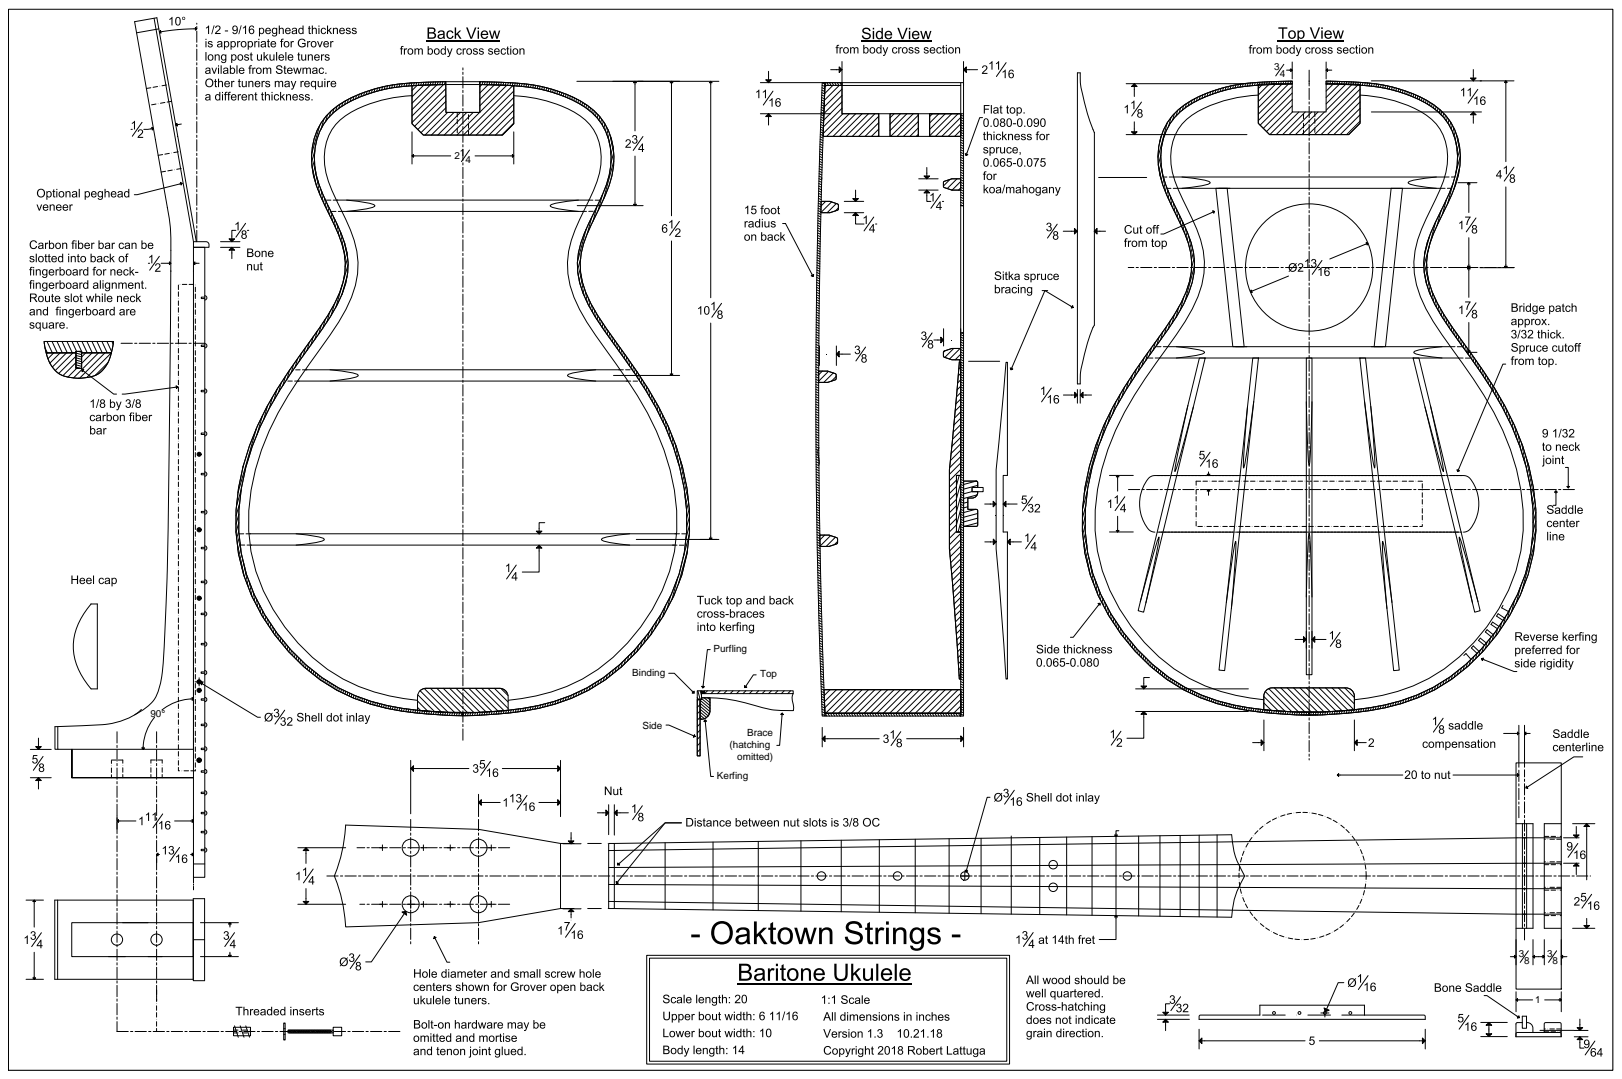
[picture p310: page 1]
Top; Side; Purfling; Brace (hatching omitted); Kerfing; Binding
