jaegertros/Ukulele/Concert Pineapple Ukulele v1.0.pdf

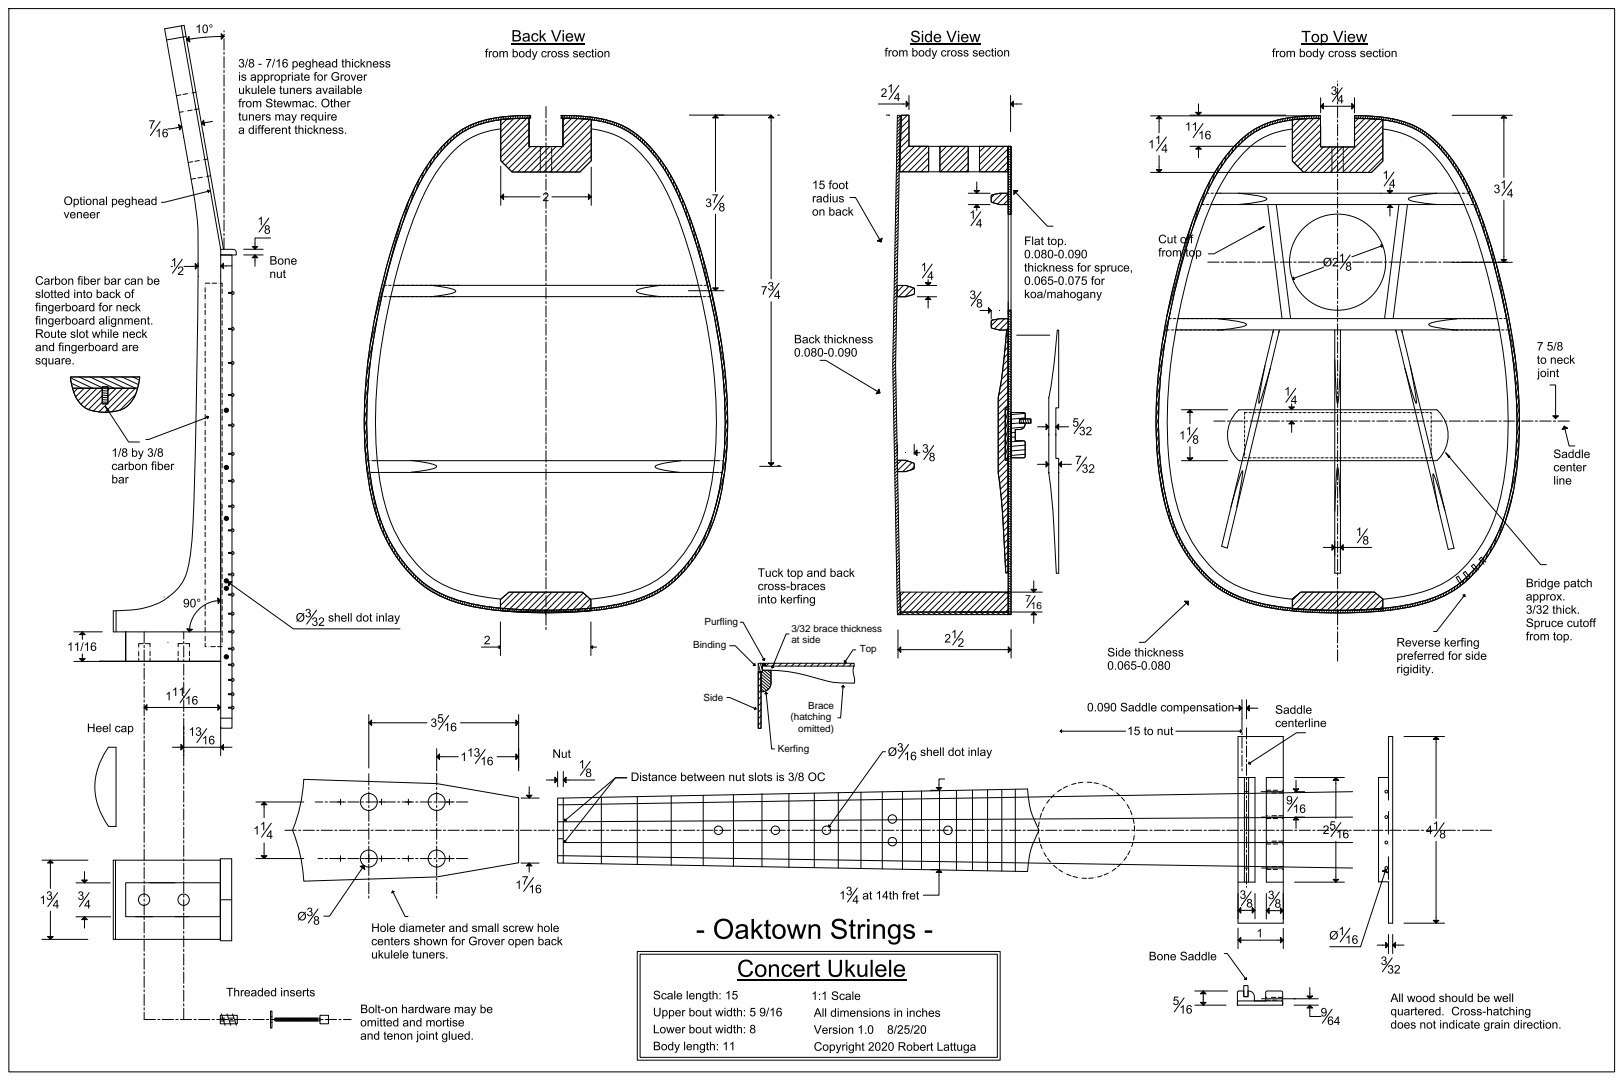
[picture p311: page 1]
Top; Side; Brace (hatching omitted); Kerfing; Binding; 3/32 brace thickness at side; Purfling
