jaegertros/Ukulele/Pineapple Tenor Ukulele V 1.3.pdf

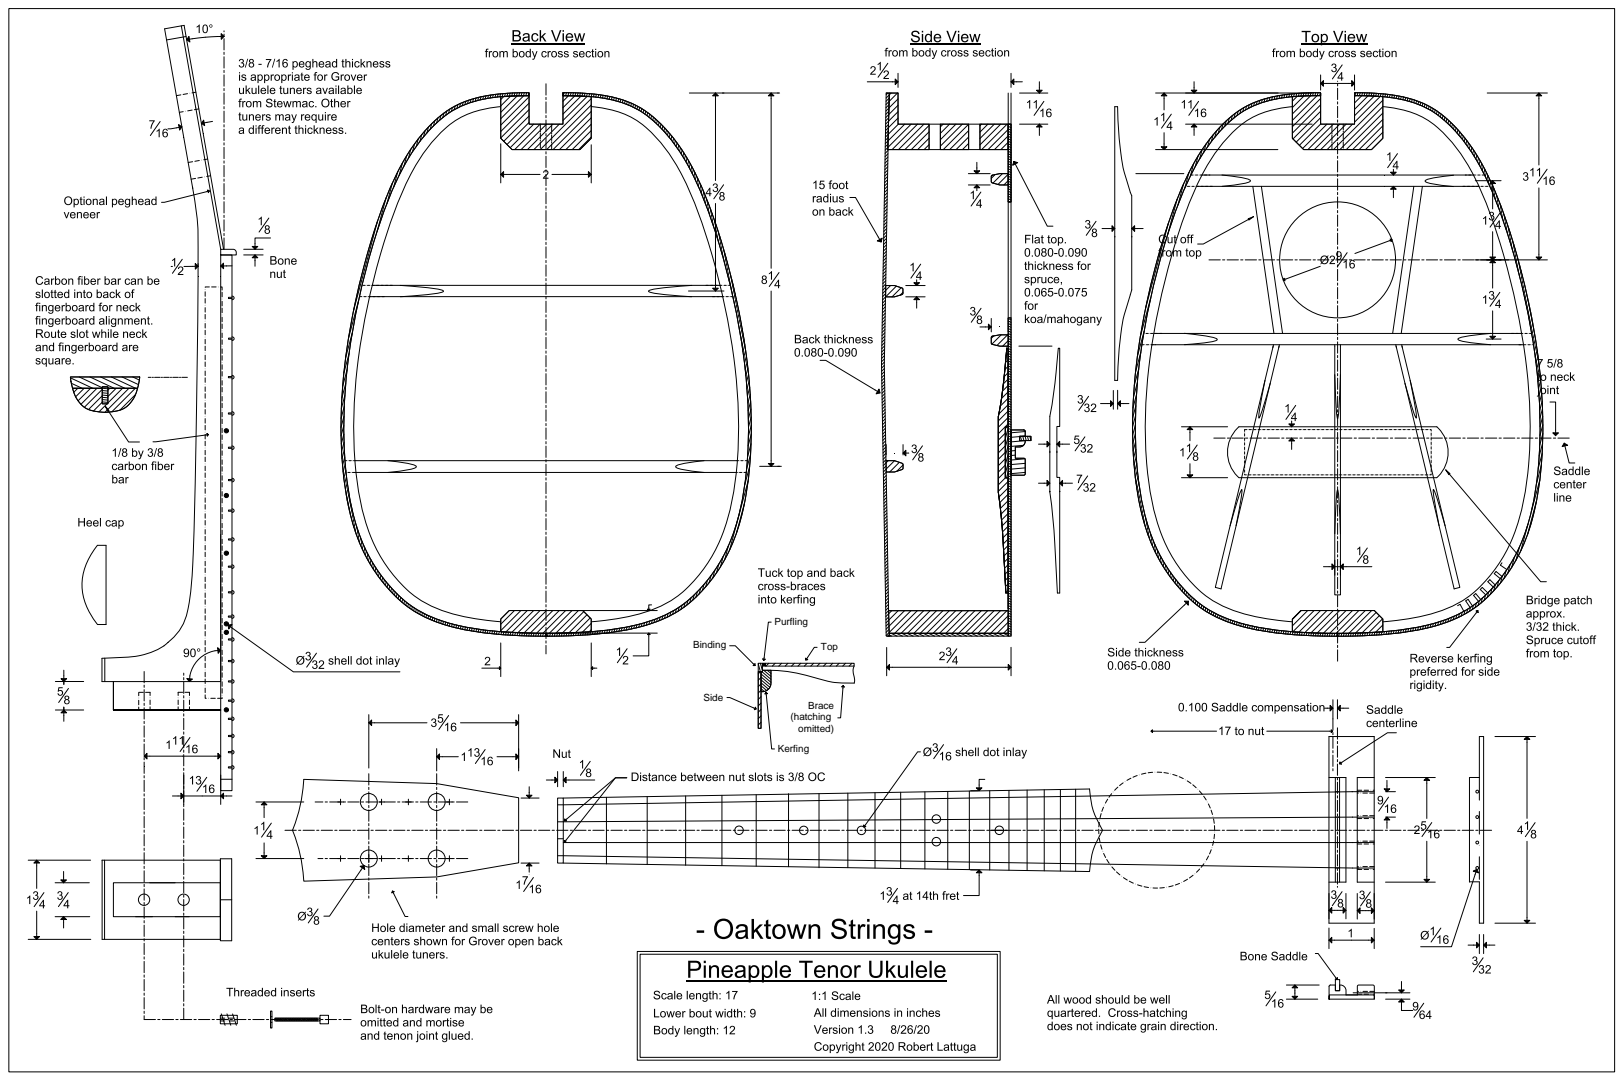
[picture p313: page 1]
Top; Side; Purfling; Brace (hatching omitted); Kerfing; Binding
