jaegertros/Ukulele/Tenor ukulele 4 v1.3.pdf

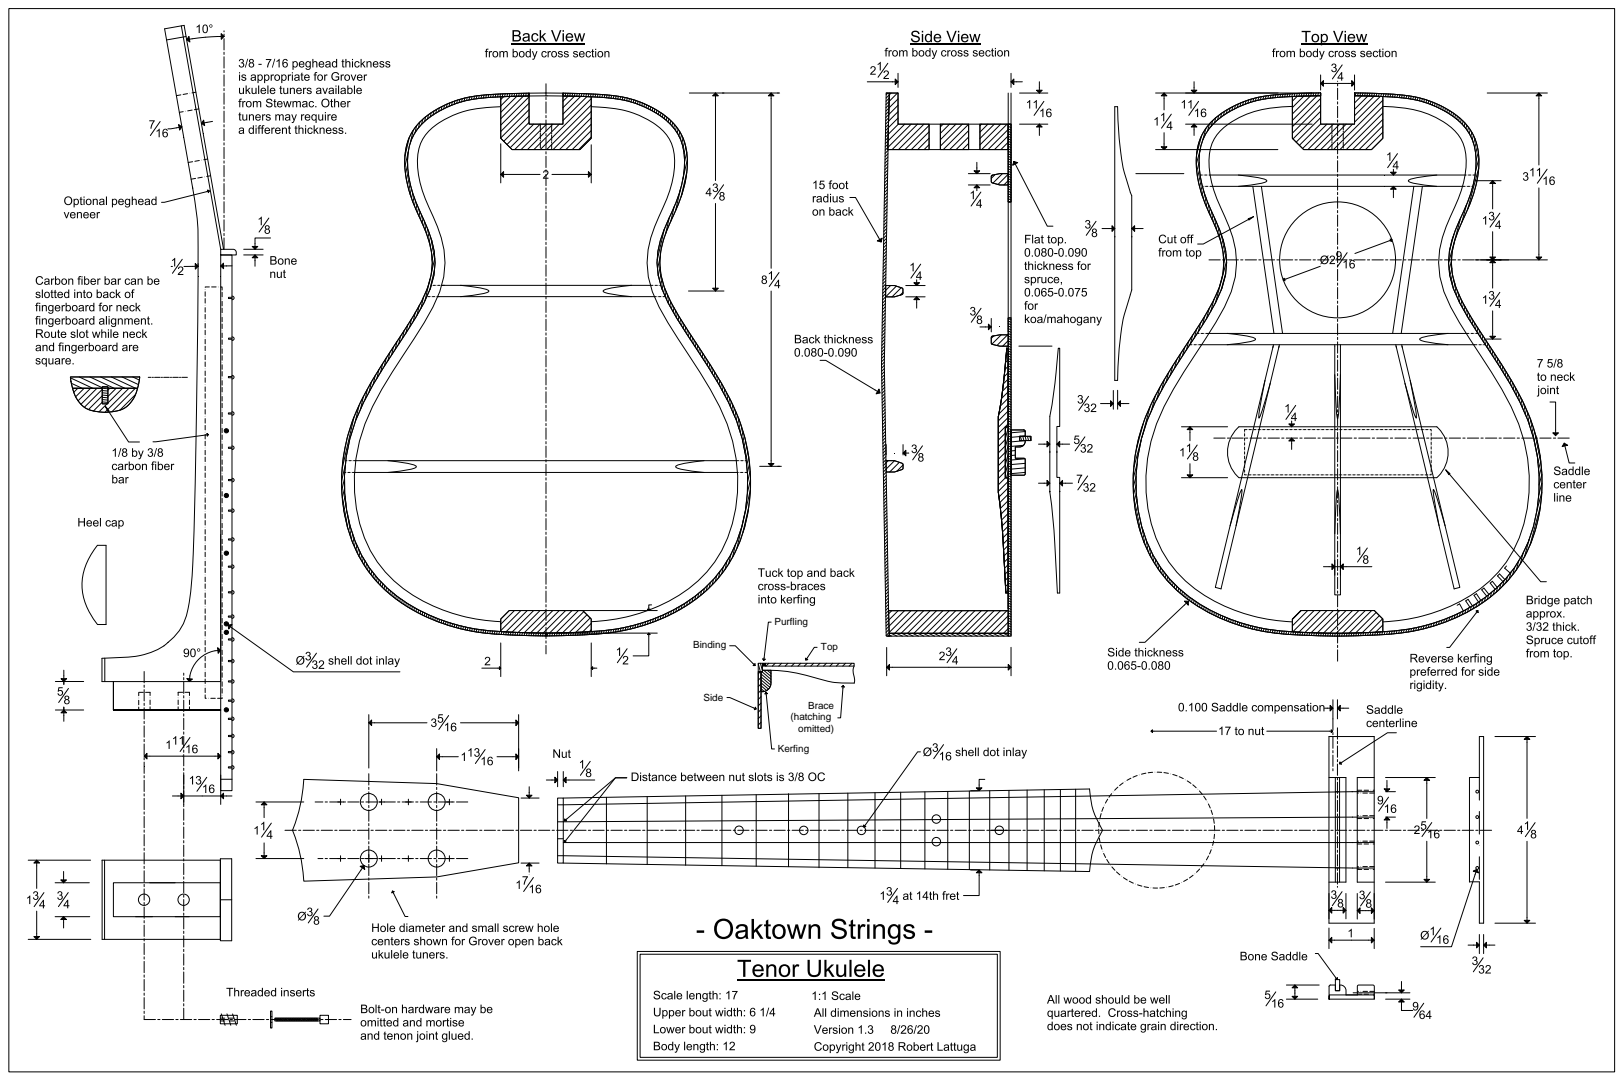
[picture p314: page 1]
Top; Side; Purfling; Brace (hatching omitted); Kerfing; Binding
